TadeoRoboticsGroup/AxiomaCore-328/README.md

<div align="center">

# AxiomaCore-328

**Microcontrolador de 8 bits, libre y abierto, compatible a nivel binario con el ATmega328P.**

Diseñado íntegramente con herramientas libres y verificado contra oráculos independientes.
**Sintetiza y cierra timing en FPGA**; falta enchufar la placa. El tape-out en un PDK abierto es
la fase 6 y no ha empezado.

*Este encabezado decía «validado en FPGA y preparado para tape-out». No era cierto —el bitstream se
genera y cierra timing, pero nunca ha corrido en una placa— y contradecía la regla que este mismo
documento fija: si no hay un comando que lo demuestre, no se afirma.*








</div>

---

## Arquitectura

<picture>
  <source media="(prefers-color-scheme: dark)" srcset="images/arquitectura-dark.png">
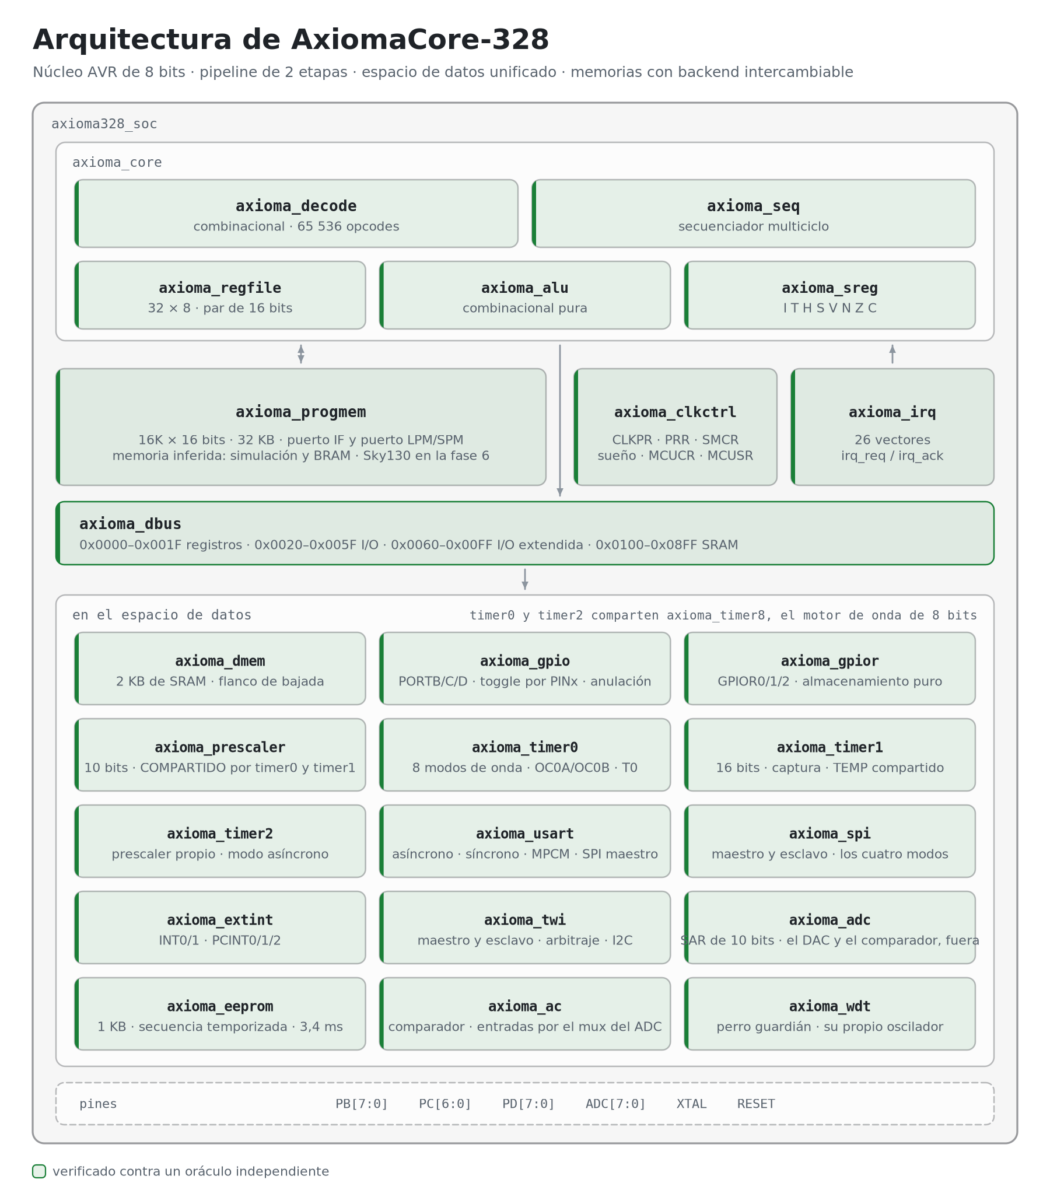
[picture p1: images/arquitectura-light.png]
Diagrama de bloques de AxiomaCore-328: núcleo, memorias, bus de datos y periféricos, con el estado de verificación de cada bloque
  
</picture>

Un núcleo AVR de 8 bits con pipeline de dos etapas, un secuenciador multiciclo que congela la
etapa de búsqueda, y memorias tras una interfaz pensada para cambiar de backend —simulación, BRAM
de FPGA o macros de SRAM en silicio— que es lo que evita que el port a ASIC sea una reescritura.
De esa interfaz hay hoy **una implementación**: memoria inferida, que vale para simulación y que la
síntesis mapea a BRAM; la de Sky130 es de la fase 6.

Los colores del diagrama no son decorativos: marcan qué está contrastado contra un oráculo
independiente y qué no. Ése es el criterio con el que se mide este proyecto — y desde que entró el
control de reloj **no queda ningún bloque pendiente en la figura**, así que la leyenda ya sólo
tiene una fila. Lo que falta del chip no es un bloque sin hacer: es el gestor de arranque de la
fase 4 y el silicio de la 6.

---

## Estado actual

Cada cifra de esta tabla sale de ejecutar `make`, no de escribirla a mano. Dos son derivadas y
conviene decirlo: las de `progmem` y `dmem` son el desglose de las 34 049 comprobaciones que
imprime `make sim-mem`, y la de la tabla de ciclos es la suma de los veintiún programas dirigidos.

| Bloque | Estado | Evidencia |
|---|---|---|
| `rtl/core/axioma_alu.v` | **Verificado** | 22 282 240 vectores sobre 24 operaciones, 0 fallos. Los mismos casos contrastados contra `simavr`: 0 discrepancias |
| `rtl/core/axioma_sreg.v` | **Verificado** | 200 029 comprobaciones contra un modelo sombra |
| `rtl/core/axioma_regfile.v` | **Verificado** | 800 064 comprobaciones en 200 000 ciclos aleatorios |
| `rtl/core/axioma_decode.v` | **Verificado** | Los 65 536 opcodes × 11 comprobaciones contra `avr-objdump`: 0 discrepancias |
| `rtl/mem/axioma_progmem.v` | **Verificado** | 12 000 comprobaciones: puerto de búsqueda, puerto de datos —`LPM` y las escrituras que le manda `axioma_spm`— y los dos a la vez |
| `rtl/mem/axioma_dmem.v` | **Verificado** | 22 049 comprobaciones, incluido el barrido completo de las 2048 direcciones y la disciplina de flanco del [ADR 0001](docs/adr/0001-memorias-en-flanco-de-bajada.md) |
| `rtl/bus/axioma_dbus.v` | **Verificado** | 790 976 comprobaciones sobre las 65 536 direcciones del espacio de datos, 0 fallos |
| `rtl/periph/axioma_gpio.v` | **Verificado** | Diferencial contra `simavr` sobre los tres puertos, más **910 200 comprobaciones** por máscara contra un modelo de la hoja de datos, incluido `PUD` |
| `rtl/periph/axioma_timer0.v` | **Verificado** | 4 480 668 comprobaciones en 224 032 ciclos contra un modelo de la hoja de datos: los ocho modos de onda, el doble búfer de `OCR0x`, las banderas y los pines de comparación |
| `rtl/periph/axioma_prescaler.v` | **Verificado** | Ídem: es el contador **compartido** con el Timer1, y la trampa nº 12 —que arrancar un temporizador no lo pone a cero— sólo se puede comprobar con los dos juntos |
| `rtl/periph/axioma_irq.v` | **Verificado** | **Exhaustivo**: las 67 108 864 combinaciones de las 26 peticiones, 201 326 592 comprobaciones de prioridad y reconocimiento |
| `rtl/periph/axioma_timer1.v` | **Verificado** | **4 475 970 comprobaciones** contra un modelo de la hoja de datos: los 16 modos de onda, la captura de entrada con su cancelador de ruido, y **el registro TEMP compartido** —la trampa nº 4—, que simavr no modela |
| `rtl/periph/axioma_usart.v` | **Verificado** | **46 650 comprobaciones** contra extremos escritos desde la hoja de datos que decodifican el pin. **Asíncrono:** las cinco longitudes de palabra, las tres paridades, uno y dos bits de parada, con y sin U2X, el periodo de bit exacto, el búfer de dos niveles y la búsqueda de errores. **Síncrono:** el periodo de `XCK` contra `f_CPU/(2·(UBRR+1))` desde `UBRR=0` —que es `f_CPU/2`—, las dos polaridades de `UCPOL` comprobadas **en el flanco** y no sólo por el dato, de maestro y de esclavo. **`MPCM`:** las tramas de datos se tiran en silencio y las de dirección entran. **SPI maestro (`MSPIM`):** los cuatro modos de `UCPOL`/`UCPHA` por los dos órdenes de bit contra un **esclavo SPI** al otro lado del cable, que una trama sean **ocho pulsos y ni uno más**, y que `XCK` esté quieto entre ellas |
| `rtl/periph/axioma_timer2.v` | **Verificado** | **4 666 627 comprobaciones** contra un modelo de la hoja de datos: las ocho tomas de su **prescaler propio** —incluidas `/32` y `/128`, que los otros dos no tienen—, que `PSRASY` lo ponga a cero y `PSRSYNC` no lo toque, y el **modo asíncrono**, que cuenta `TOSC1` y sin cristal no cuenta |
| `rtl/periph/axioma_timer8.v` | **Verificado** | La máquina de forma de onda de 8 bits, **una sola vez para el Timer0 y el Timer2**: la hoja de datos los describe con las mismas palabras. La ejercitan los dos bancos, y un mutante inyectado en ella muere en los dos |
| `rtl/periph/axioma_spi.v` | **Verificado** | **Maestro y esclavo**, contra el otro extremo del cable escrito desde la hoja de datos: los cuatro modos de `CPOL`/`CPHA` por los dos órdenes de bit, las ocho divisiones de reloj, `WCOL`, la secuencia de dos accesos que limpia `SPIF`, y que la colisión de maestros **no** salte cuando `SS` es salida —que es como selecciona a su esclavo cualquier sketch— |
| `rtl/periph/axioma_twi.v` | **Verificado** | **5 957 comprobaciones** contra un **bus de colector abierto** con un maestro y un esclavo I2C escritos desde la hoja de datos: los 26 códigos de estado de las tablas 21-2 a 21-6, las 128 direcciones de esclavo una por una, `TWAMR` contrastada contra su fórmula sobre las 128, la llamada general, el **arbitraje** —perder, no perder con los ceros propios, y perder siendo además el llamado, que da 0x68 y no 0x38—, el **estiramiento de reloj**, el error de bus y el periodo de `SCL` medido contra `f_CPU/(16+2·TWBR·4^TWPS)` en ocho combinaciones |
| `rtl/periph/axioma_adc.v` | **Verificado** | **1 606 comprobaciones** contra un **comparador escrito desde la hoja de datos**, que es lo que el [ADR 0002](docs/adr/0002-frontera-analogica-del-adc.md) compra al dejar el DAC y el comparador FUERA del RTL: se comprueba que el SAR **converge** —las diez decisiones, en orden de peso— y no sólo que el número final salga. Los **1 024 códigos** uno por uno; la duración medida **entre transiciones del DAC**, que son lo único con registro uniforme: **13 ciclos de ADC** una conversión normal y **25 la primera**; el instante del `S/H` a 1,5 y 13,5 ciclos, comprobado con la entrada moviéndose; el cerrojo de `ADCL`/`ADCH`; `ADLAR`; y el prescaler, con su `ADPS`=0 y `ADPS`=1 que dividen los dos por 2. **Y de extremo a extremo:** `hello.c` convierte el canal 3 y escribe el resultado por el puerto serie, así que el número cruza el chip entero —bus, SAR, frente analógico, registros con su cerrojo, USART y PD1— y el banco lo lee **del pin** |
| `rtl/periph/axioma_ac.v` | **Verificado** | **2 045 comprobaciones**. La comparación es analógica y llega hecha; lo que se verifica es lo que un comparador de tensión no sabe hacer solo: que `ACO` llegue **sincronizada** —«1 - 2 clock cycles», dice la hoja de datos—, los tres modos de `ACIS` con el reservado tratado como el chip lo trata, la **tabla 22-1** de la entrada negativa —el multiplexor del ADC sólo la alimenta con `ACME` puesto **y el ADC apagado**—, `DIDR1`, y que apagar el comparador **deje la interrupción de la que avisa el manual**, que es un fallo de compatibilidad que encontró la mutación |
| `rtl/periph/axioma_wdt.v` | **Verificado** | **43 comprobaciones** contra el capítulo 11 de la hoja de datos. Lo que de verdad se verifica es la **secuencia temporizada** —`WDCE` y `WDE` a uno a la vez, y el valor dentro de los cuatro ciclos siguientes—, porque un perro guardián que se pueda apagar con una escritura suelta no sirve para nada: lo que vigila es justamente un programa desbocado. Más los periodos de la tabla 11-1 —2K ciclos del oscilador por su potencia de dos—, el **orden raro de los bits** de `WDTCSR` —`WDP3` en el bit 5, con `WDCE` y `WDE` en medio—, `WDR`, y los tres modos de la tabla 11-2, incluido el que **interrumpe y después reinicia** limpiando `WDIE` para darle a la ISR un periodo entero |
| `rtl/periph/axioma_eeprom.v` | **Verificado** | **49 comprobaciones** contra el capítulo 8. Tres cosas, por orden de lo que duele si falla: la **secuencia temporizada** —`EEMPE` y, dentro de cuatro ciclos, `EEPE`—, porque una escritura perdida en la EEPROM no se nota hasta el siguiente arranque y para entonces el dato bueno ya no está; **la física de la celda**, que borra a `0xFF` y al escribir sin borrar sólo puede **apagar** unos —tratarla como RAM haría funcionar aquí código que en silicio no funciona—; y **el tiempo**, 3,4 ms borrando y escribiendo y 1,8 ms haciendo sólo una de las dos, medido en ciclos del oscilador. Más `EE_READY`, que es de **nivel** y no de bandera, y las diez líneas de dirección una por una. **1 KB en una sola BRAM** |
| `rtl/periph/axioma_extint.v` | **Verificado** | **2 501 159 comprobaciones** contra un modelo de la hoja de datos, más un programa de co-simulación contra `simavr`: los cuatro modos de `ISCn`, el de **nivel bajo** —que no deja bandera y sostiene la petición—, que la bandera se ponga con el vector deshabilitado, y que `PCMSKn` filtre la bandera mientras `PCICR` sólo filtra el salto |
| `rtl/periph/axioma_gpior.v` | **Verificado** | `GPIOR0/1/2`, tres bytes de almacenamiento del 328P. Diferencial contra `simavr` y barrido del mapa |
| `rtl/fpga/ecp5/axioma_ulx3s_top.v` | **Sintetiza y cierra timing** | Bitstream de 300 KiB para la ULX3S 25F. `nextpnr` mide **Fmax 18,25 MHz** tras el rutado, bajo restricción exigente; se corre a 12,5 MHz, con un margen de 1,46× |
| `fw/hello/hello.c` | **Verificado** | **El criterio de aceptación de la fase 2, menos el cable.** C compilado con avr-gcc y avr-libc sin modificar, corriendo sobre el SoC completo: el banco decodifica el **pin** y lee `Hola, AxiomaCore-328`, mide 19 055 baudios contra 19 200 nominales (−0,76 %), ve parpadear PB5, **decodifica del pin una transacción SPI** de tres bytes con el reloj de `SCK`, **decodifica también una transacción de la USART en modo SPI maestro** —`XCK` en PD4 con 48 flancos exactos y los bytes por PD1— y **una del TWI** —el START, la dirección `0xA0` y el STOP sobre `SDA`=PC4 y `SCL`=PC5—, y **mide el ciclo de trabajo de los SEIS canales PWM a la vez**, cada uno en su pin y con un ciclo distinto a propósito —25,39 · 78,50 · 37,49 · 74,86 · 12,49 · 62,48 %—, contra lo que da la hoja de datos. Seis cifras distintas es lo que hace visible un mapa de pines cruzado |
| `fw/blink/blink.c` | **Verificado** | C compilado con avr-gcc y avr-libc **sin modificar**: 50 000 instrucciones contra `simavr`, exactas en ciclos, con 4 entradas a ISR |
| `rtl/soc/axioma328_soc.v` | **Verificado** | **La integración es diseño, no banco de pruebas.** Las **221 direcciones** del espacio de I/O barridas por el bus real —las 224 del mapa menos las tres que el núcleo intercepta, `SPL`, `SPH` y `SREG`—: sin colisiones, el mapa coincide con la hoja de datos y los huecos se leen como `0x00` |
| `rtl/core/axioma_seq.v` | **Verificado** | 21 programas dirigidos + 10⁶ instrucciones aleatorias, 0 divergencias en estado, ciclos y espacio de datos |
| `rtl/core/axioma_core.v` | **Verificado** | Ídem. Es el módulo que une todo |
| Tabla de ciclos (nivel L3) | **Verificada** | 380 048 instrucciones con sus ciclos contrastados contra el manual, 0 desviaciones · **97 de 97 mnemónicos** |
| Regresión aleatoria | **Verde** | 10 programas × 100 000 instrucciones generadas con semilla fija, 0 divergencias |
| Entrada a interrupción | **Verificada** | 2 510 entradas a ISR contrastadas contra `simavr`, que ejecuta su propia secuencia de entrada: vector, pila, `SP` y bit `I`. Cuesta 4 ciclos, como dice el manual. Encontró dos fallos reales (ver abajo) |
| `rtl/periph/axioma_wdt.v`, `axioma_eeprom.v`, `axioma_adc.v`, `axioma_ac.v` | **Verificados** | Sus filas están arriba. Los cuatro entraron entre el 17 y el 21 de septiembre |
| `rtl/periph/axioma_clkctrl.v` | **Verificado** | `CLKPR` con su división medida en el pin, `PRR` apagando los siete periféricos uno a uno, `SMCR` con los seis modos de sueño, `MCUCR` con `PUD`, y `MCUSR`. El décimo de los diez |
| `rtl/periph/axioma_spm.v` | **Verificado** | La Flash **por páginas**: `SPMCSR`, búfer temporal de 64 palabras y las tres operaciones. 28 comprobaciones contra el capítulo 26 —el arnés diferencial no sirve aquí: un programa que se reescribe la Flash cambia el código que los dos lados ejecutan—, más la secuencia entera de un gestor de arranque en `make sim-robust`. Trajo el vector 25 |
| Síntesis FPGA, GDSII | No ejecutadas | Fases 2 y 6 |

```
regresión   48/48 objetivos en verde
mutación   329/329 fallos inyectados, 329 detectados
cobertura   99,8 % del RTL, fusionando todas las fuentes
            22 de 28 módulos al 100 %; los 14 puntos restantes, adjudicados:
            los `default` inalcanzables de la ALU y del TWI —sus casos están
            enumerados—, el `$readmemh` que sólo corre con programa precargado,
            el `next_warmup` que sólo pone el reset, y líneas de declaración cuyos
            bits van atados a constante
síntesis    sin latches · el SoC entero: 8 146 LUT4 y 1 475 FF en el ECP5
            es una MEDIDA, no un criterio: yosys aplana y comparte lógica, así
            que un cambio local mueve el total en cientos. El número atribuible
            es el de cada módulo por separado
bitstream   300 KiB · 35,4 % de las LUT y 60,7 % de la BRAM de la ULX3S 25F
            Fmax 18,25 MHz medida tras el rutado, y se corre a 12,5 MHz
            cada periférico nuevo baja un poco el Fmax; el objetivo de la fase 5
            son 32 MHz, y para eso hace falta sacar el dato de escritura de la
            SRAM del camino combinacional
```

**La fase 1 cumple su criterio de aceptación, y su única deuda está saldada.** La entrada a
interrupción, que no se podía ejercitar sin un controlador, ya se dispara desde el Timer0. Al
hacerlo aparecieron **dos fallos reales** en esa ruta: el secuenciador calculaba la dirección del
vector multiplicando por cuatro en vez de por dos, y su máquina de estados de entrada se caía al
`case` de instrucciones en los ciclos 1 a 3, porque la condición que la sostenía dejaba de
cumplirse en cuanto el primer ciclo limpiaba el bit `I`.

**Cuánto queda, y medido contra qué.** El [plan](docs/00-PLAN.md) presupuesta las fases en semanas:
1 + 4 + 2 + 5 + 3 + 2 = **17 semanas** hasta la v1.0 sobre FPGA, y de 6 a 10 más si hay silicio. La
cuenta se hace con esos pesos, no a ojo:

| Fase | Semanas | Hecho | Aporta |
|---|---:|---:|---:|
| 0 · fundación | 1 | 100 % | 1,00 |
| 1 · núcleo ISA | 4 | 100 % | 4,00 |
| 2 · SoC y FPGA | 2 | 90 % — cumplida en simulación, falta enchufar la placa | 1,80 |
| 3 · periféricos | 5 | **100 %** — las tareas y las tres cláusulas del criterio | 5,00 |
| 4 · Arduino | 3 | 80 % — `SPM`, gestor, `axioma.conf`, `boards.txt` y tres sketches cronometrados; faltan siete y publicar el paquete | 2,40 |
| 5 · endurecimiento | 2 | 0 % | 0,00 |
| | **17** | | **14,20** |

Salen **~83 % hasta la v1.0 en FPGA**. Contando el silicio —de 6 a 10 semanas más— quedaría entre
un 52 % y un 61 %, y **~56 %** tomando el punto medio. Es el presupuesto del propio plan, no una
impresión.

Los **diez periféricos de la fase 3 están dentro**, más el `SPM` por páginas que abre la fase 4, y
el mapa de registros está **barrido bit a bit**: 664 bits en 83 registros, 399 de almacenamiento,
136 con comportamiento propio y 129 reservados, **ninguno sin clasificar**. Y **los 25 vectores de
interrupción disparan desde un programa**.

El **criterio de aceptación** de la fase son tres cláusulas, y **las tres están demostradas**
desde el 24-sep:
`micros()` **no deriva** —200 y 800 periodos dan el mismo desvío de 13 ciclos, así que es latencia
acotada y no deriva— y el **scanner I2C encuentra un esclavo real y sólo a él** —127 direcciones
barridas, una contesta; con el esclavo mudo, ninguna—. Y **los 25 vectores disparan**: el que
faltaba era `SPM_READY`, y su fuente llegó con el `SPM` por páginas, que es la primera pieza de la
**fase 4**.

> Este README documenta el estado **medido**. Una versión anterior describía un diseño terminado
> y listo para producción que no existía. La regla desde entonces es simple: si no hay un comando
> que lo demuestre, no se afirma.

**➜ El plan completo está en [`docs/00-PLAN.md`](docs/00-PLAN.md).**

---

## Qué significa «compatible»

«Copia exacta» significa cosas distintas según a quién se pregunte. Aquí está fijado por escrito
en cuatro niveles, y sólo tres son alcanzables con herramientas libres.

| Nivel | Qué garantiza | ¿Objetivo? | Cómo se verifica |
|---|---|---|---|
| **L1 — Binaria** | 131 instrucciones, semántica exacta del SREG, PC de 14 bits, pila, interrupciones | Obligatorio | Diferencial contra `simavr`, instrucción a instrucción |
| **L2 — Registros** | Mismas direcciones, nombres y bits. `avr/io.h` con `-mmcu=atmega328p` funciona sin tocar nada | Obligatorio | Mapa generado desde `iom328p.h` de avr-libc, con test de CI. Y **bit a bit**: `make sim-bits` clasifica los 664 bits de los 83 registros y comprueba que **ningún reservado devuelve un uno** |
| **L3 — Ciclos** | Misma cuenta de ciclos por instrucción y misma temporización de periféricos | Sí | Tabla del manual del ISA como fichero de datos, comprobada en cada instrucción retirada |
| **L4 — Eléctrica** | 5 V, DIP-28, pinout idéntico | **No en el die.** Sí en el módulo | Sky130 no da 5 V; se resuelve con level shifters en la PCB |

De L3 dependen `_delay_ms()`, `micros()`, `SoftwareSerial`, `Servo` y cualquier protocolo
bit-bangeado como el de las tiras NeoPixel. Por eso se mide desde la fase 1 y no al final — y desde
la fase 4 se mide **con un cronómetro en el pin**: `make sim-neopixel` decodifica una trama WS2812B
de la anchura de sus pulsos y comprueba que T0H, T1H y el periodo caen dentro de la hoja de datos.

---

## Espacio de datos

<picture>
  <source media="(prefers-color-scheme: dark)" srcset="images/espacio-datos-dark.png">
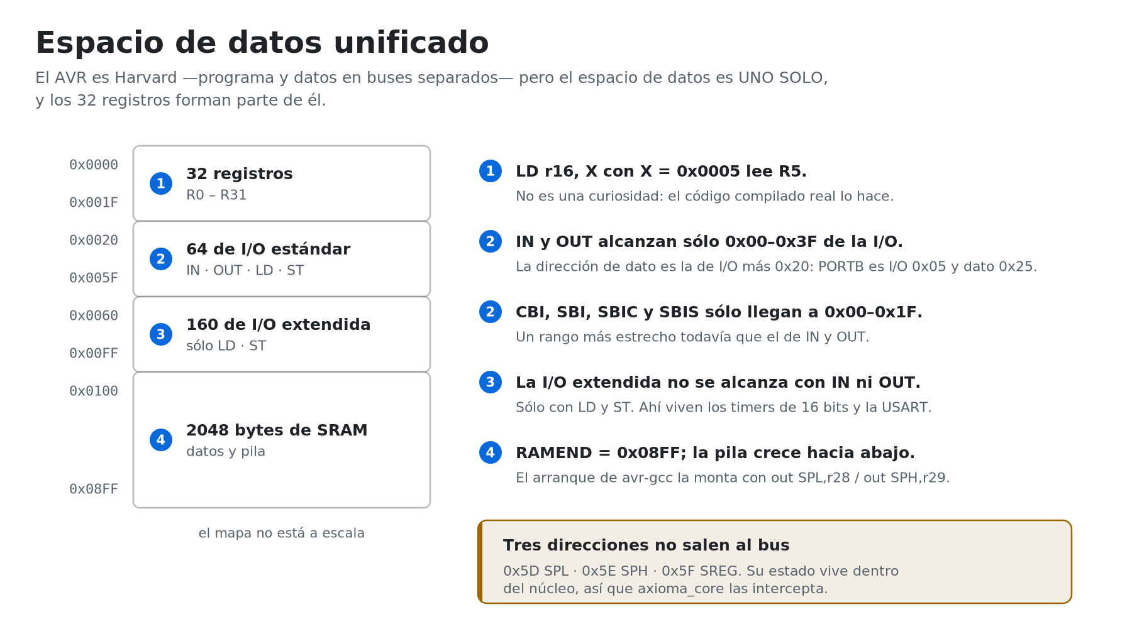
[picture p2: images/espacio-datos-light.png]
Mapa del espacio de datos unificado del AVR, de 0x0000 a 0x08FF, con las reglas de acceso de cada región
  
</picture>

El AVR es Harvard, pero su espacio de **datos** es uno solo y los registros forman parte de él.
Modelarlo de otro modo produce un núcleo que pasa los tests sintéticos y falla con código
compilado real.

---

## Verificación

<picture>
  <source media="(prefers-color-scheme: dark)" srcset="images/verificacion-dark.png">
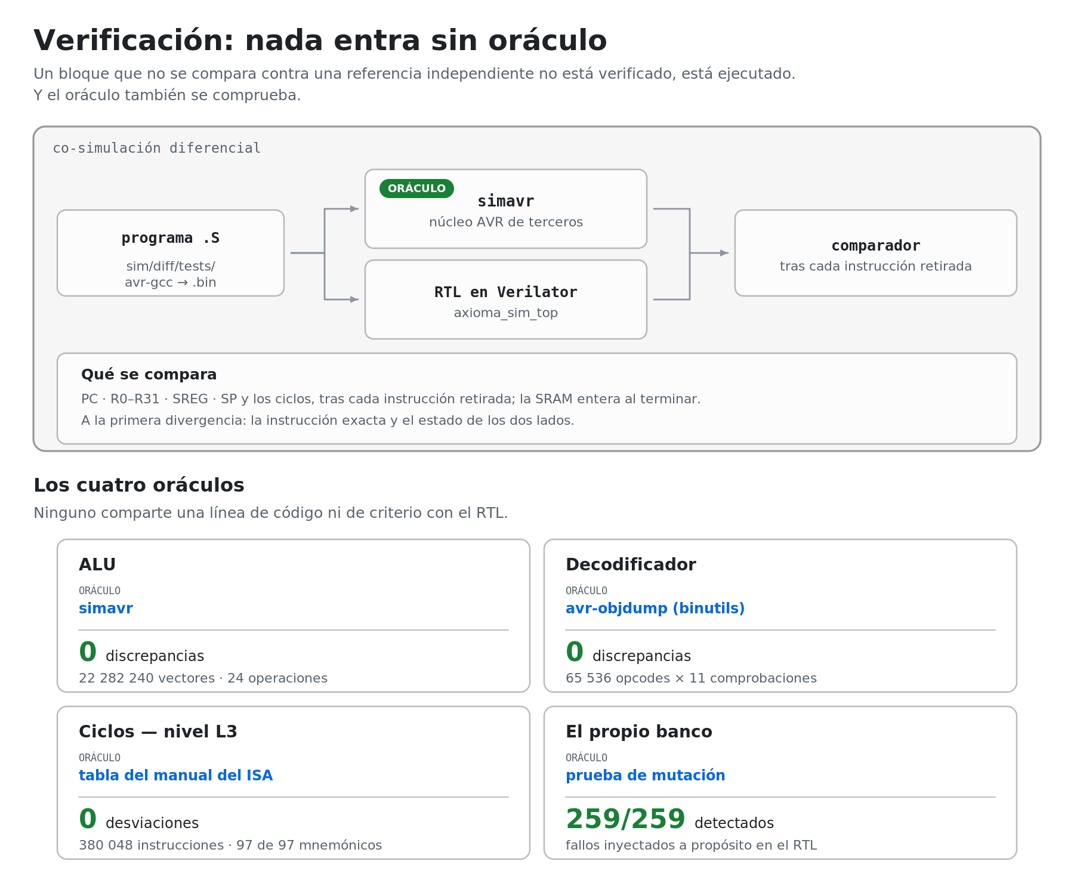
[picture p3: images/verificacion-light.png]
Esquema de la co-simulación diferencial contra simavr y resumen de los cuatro oráculos del proyecto
  
</picture>

### La regla

> **Nada entra sin oráculo. Y el oráculo también se comprueba.**

Un módulo que compila y sintetiza no cuenta como hecho. Cuenta cuando lo contrasta algo
independiente. Y como el modelo de referencia y el RTL los escribe la misma persona, hacen falta
terceros de verdad: `simavr` para la ALU y para el núcleo completo, `avr-objdump` de binutils para
el decodificador, el preprocesador de avr-gcc para el mapa de registros.

### No es teoría: fallos que sólo aparecieron así

| Fallo | Quién lo encontró | Por qué se escapaba |
|---|---|---|
| Flag `H` de `NEG` implementado como `R3 \| ¬Rd3` en vez de `R3 \| Rd3` | Contraste contra `simavr` | El mismo error estaba en el RTL **y** en el modelo de referencia, así que coincidían en los 65 536 vectores de `NEG` y ninguno podía delatar al otro. Corregir sólo uno de los dos produce **32 768 discrepancias**, medidas |
| Desfase de un ciclo en la búsqueda: cada instrucción se ejecutaba dos veces | Co-simulación diferencial | Apareció en la segunda instrucción del primer programa |
| `RET` devolvía el byte bajo duplicado | Co-simulación diferencial | Consumía la lectura de memoria del ciclo equivocado |
| `MOVW` costaba 2 ciclos donde el manual dice 1 | Comprobación de ciclos | El **estado** quedaba correcto, así que la comparación de estado lo daba por bueno |
| Cinco fallos en los propios bancos de pruebas | Prueba de mutación | El arnés de memoria no distinguía flanco de subida de bajada; el comparador del decodificador no miraba `alu_op`, con lo que confundir `ADD` con `ADC` pasaba el test |
| El arnés no comparaba la memoria | Auditoría de cobertura | `ST`, `STS`, `PUSH`, `OUT`, `SBI` y `CBI` escriben sin leer: una escritura a la dirección equivocada sólo se notaba si el programa la releía |

El caso de `MOVW` es el que mejor explica por qué hay tantas capas: la causa no estaba en el
secuenciador sino en la **interfaz** del banco de registros, que direccionaba lectura y escritura
de 16 bits con el mismo índice de par. Copiar de un par a otro exigía dos ciclos. El documento de
arquitectura ya decía que debía costar uno; el que contradecía al documento era el RTL.

### Reproducirlo

```bash
source env.sh
make check-tools
make check-all
```

**Los cuarenta y tres objetivos deben pasar**, y tardan unos veinte minutos en un portátil — la
cobertura y la co-simulación diferencial son casi todo; `synth-check` sintetiza veintitrés
módulos por separado y tarda poco. **La lista de lo que tiene que pasar vive en el `Makefile`, en
la variable `REGRESION`, y en ningún otro sitio**: estaba copiada aquí, en `INSTALL.md` y en la CI,
y tres copias de una lista son tres cifras que se desincronizan. Ya pasó con la cuenta de
objetivos, y estas dos —cuarenta y tres y veintitrés— se volvieron a medir el 24-sep.

La prueba de mutación va aparte, porque tarda y **modifica el RTL mientras corre**:

```bash
make mutation      # 329 fallos inyectados, ~25 min; MODIFICA el RTL mientras corre
```

**Los cuarenta y tres objetivos deben pasar**, y tardan unos veinte minutos en un portátil. La
prueba de mutación va aparte:

```bash
make mutation      # 329 fallos inyectados, ~25 min; MODIFICA el RTL mientras corre
```

La co-simulación diferencial recoge sola cualquier `.S` que aparezca en `sim/diff/tests/`. Hoy son
**veintiún programas**: tres de aritmética, control de flujo y memoria; cuatro dirigidos que
completan el conjunto de instrucciones —bits y espacio de I/O, las 16 ramas condicionales, `LPM` en
sus tres formas, y el control del sistema—; uno de puertos de E/S; uno que escribe por la USART sin
interrupciones; **uno que reproduce el bucle de limpieza de `.bss` que emite el enlazador**, que es
cómo el compilador compara punteros; y diez que entran en la rutina de interrupción de verdad,
desde los tres temporizadores, la USART, el SPI, el TWI, el ADC, el comparador analógico, la EEPROM,
el perro guardián y los cinco vectores externos. Entre todos ejercitan
**los 97 mnemónicos** que el ATmega328P puede ejecutar. Tras cada instrucción se comparan PC, los 32 registros, SREG, SP y los ciclos; al
terminar, la SRAM entera byte a byte.

> **97 mnemónicos y 131 instrucciones no se contradicen.** La cifra de 131 es la del manual del ISA
> y cuenta variantes que comparten codificación: `LSL` es `ADD Rd,Rd`, `CLR` es `EOR Rd,Rd`, `TST`
> es `AND Rd,Rd`, `SER` es `LDI Rd,0xFF`, y `BRBS`/`BRBC` se despliegan en dieciséis ramas con
> nombre propio. La cobertura se mide en mnemónicos porque es lo que devuelve `avr-objdump`, que es
> el oráculo: así el número sale de una herramienta y no de un recuento a mano. Los 97 son todos
> los que el 328P puede ejecutar; `SPM` es la única exclusión y es deliberada.

```bash
make mutation      # ~25 min · inyecta 329 fallos y comprueba que la regresión los caza
```

A eso se le suman **10⁶ instrucciones aleatorias** (`make sim-random`): programas válidos con
operandos aleatorios, generados con semilla fija, de modo que un fallo se reproduce exactamente con
el mismo comando. Lo difícil de un generador así no es la aleatoriedad, sino garantizar que nunca
hace algo cuyo resultado no esté definido o que los dos lados no puedan modelar igual; las
restricciones y su porqué están documentadas en la cabecera del generador.

Además, `SPM` queda fuera de la suite a propósito: el manual no le fija un número de ciclos
—dependen del backend de memoria de programa— y su emulación en simavr no es comparable.

`make mutation` **modifica el RTL en sitio** mientras corre. Tiene cerrojo y manejadores de señal,
pero no debe ejecutarse en paralelo con nada más.

Para depurar el núcleo, el arnés señala la instrucción exacta donde diverge, con el estado de los
dos lados:

```bash
./build/vdiff/diff build/diff/flow.bin
```

Estrategia completa, en seis capas: [`docs/03-verificacion.md`](docs/03-verificacion.md).

---

## Plataforma de validación

<div align="center">
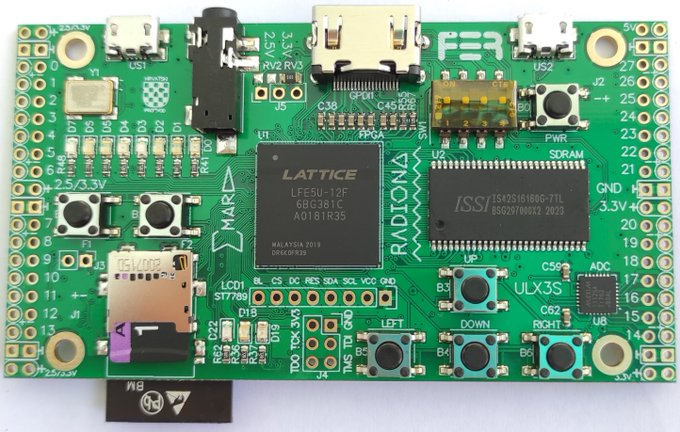
[picture p4: images/ulx3s-v316-top.jpg]
Placa ULX3S con una FPGA Lattice ECP5, memoria SDRAM, HDMI, ranura microSD y conectores de expansión
  
</div>

<div align="center">
  <sub>
    ULX3S · fotografía del repositorio <a href="https://github.com/emard/ulx3s">emard/ulx3s</a>,
    © 2016-2018 EMARD, bajo licencia tipo MIT. La unidad fotografiada monta un LFE5U-12F;
    la variante que este proyecto tiene medida es la de <strong>25F</strong>. Es la misma
    placa en las cuatro: lo único que cambia es el tamaño de la FPGA.
  </sub>
</div>

La **ULX3S** es la plataforma primaria: ECP5 con toolchain enteramente libre (yosys + nextpnr-ecp5 +
prjtrellis). El bitstream que hay medido es el de la variante **25F** —`LFE5U-25F`, 24 k LUT4— y
ocupa el **35,4 % de las LUT y el 60,7 % de la BRAM**, así que sobra sitio para el programa de
32 KB, los 2 KB de SRAM y el 1 KB de EEPROM, y sobran pines para los tres puertos.

### Dónde comprarla, con enlaces comprobados

| Placa | FPGA | Lógica | Ocupa el SoC | Dónde comprar | Precio |
|---|---|---|---|---|---|
| **ULX3S 45F** | ECP5 `LFE5U-45F` | 44 k LUT4 | ~18 % | [Mouser `CS-ULX3S-02`](https://www.mouser.com/ProductDetail/Radiona/CS-ULX3S-02) · [Electromaker](https://www.electromaker.io/shop/product/ulx3s-with-ecp5-45f) | USD, ver enlace |
| **ULX3S 85F** | ECP5 `LFE5U-85F` | 84 k LUT4 | ~10 % | [Mouser `CS-ULX3S-03`](https://www.mouser.com/en/ProductDetail/Radiona/CS-ULX3S-03) **(con existencias)** · [Crowd Supply](https://www.crowdsupply.com/radiona/ulx3s) | ~155 USD en Crowd Supply |
| ULX3S 12F | ECP5 `LFE5U-12F` | 12 k LUT4 | ~66 %, **sin medir** | [Mouser `CS-ULX3S-01`](https://www.mouser.com/ProductDetail/Radiona/CS-ULX3S-01) (bajo pedido) | USD, ver enlace |
| Colorlight 5A-75B | ECP5 `LFE5U-25F` | 24 k LUT4 | 35 % | AliExpress y eBay, varios vendedores | ~20 USD |
| Tang Nano 9K | Gowin GW1NR-9 | 8,6 k LUT4 | **no cabe** | [Sipeed en AliExpress](https://www.aliexpress.com/w/wholesale-tang-nano-9k.html) | ~18 USD |

**Tres cosas que conviene saber antes de pagar**, y que salieron de comprobar los enlaces uno a uno
el **24 de septiembre de 2026**:

1. **La variante 25F no se vende como referencia suelta.** Radiona la documenta, pero las
   referencias que los distribuidores tienen en catálogo son `CS-ULX3S-01` (12F), `-02` (45F) y
   `-03` (85F). Este proyecto está medido en la 25F porque es lo que fija el `Makefile`
   (`ECP5_DEV ?= 25k`), y en una 45F o una 85F entra con más holgura todavía: **son placas
   idénticas con la FPGA más grande**.
2. **La tienda del fabricante no envía a Colombia.** [Lectronz](https://lectronz.com/products/ulx3s-85f-v3-1-8)
   —la tienda de Intergalaktik, en Zagreb— pide **247,80 USD** por la 85F, estaba **agotada**, y su
   propia ficha dice *«This product does not ship to Colombia»*. **Mouser sí envía**, y es el camino
   sensato desde aquí.
3. **Los precios de Mouser y Crowd Supply no se pueden leer automáticamente** —las dos webs
   rechazan la lectura—, así que en la tabla van los enlaces y no una cifra inventada. El único
   precio leído directamente de su página es el de Lectronz.

**En pesos, para hacerse una idea.** La TRM del **24-sep-2026** fue de **3 264,39 COP/USD**
([Banco de la República](https://suameca.banrep.gov.co/estadisticas-economicas/informacionSerie/1/tasa_cambio_peso_colombiano_trm_dolar_usd)),
así que los **155 USD** de la 85F en Crowd Supply son unos **506 000 COP** *antes* de envío y de
aranceles de importación, que Mouser calcula en el carrito y que en Colombia no son pequeños. La
TRM cambia todos los días: el número sirve de referencia, no de presupuesto.

### Si el objetivo es un SoC con Linux, no un ATmega

Merece una aclaración, porque cambia qué placa comprar. **Una ECP5 no puede ser una Raspberry Pi 3
o 5**: ésas son SoC ARM de silicio fijo con GPU, fabricadas a 28 y 16 nm, y no existe RTL de ellas
ni cabrían. Lo que una ECP5 **sí** hace —y es justo aquello por lo que la ULX3S es conocida— es
llevar un **SoC RISC-V capaz de arrancar Linux** (LiteX, SaxonSoc), con la SDRAM, el HDMI y la
tarjeta SD de la propia placa.

Para eso, **la 85F es la compra correcta**: los 84 k LUT4 dan sitio de sobra para un núcleo RISC-V
con MMU, caches y periféricos, donde la 25F se queda corta. Está además la
[**ULX4M**](https://www.crowdsupply.com/intergalaktik/ulx4m), del mismo equipo, pensada como módulo
con hasta 1 GB de DDR3 — pero su
[repositorio](https://github.com/intergalaktik/ULX4M) la describe todavía **en desarrollo y sin
canal de venta**, así que hoy no es una opción de compra, sólo algo que vigilar.

El SoC está escrito para que cambiar de familia sea cambiar el top y las constraints bajo
`rtl/fpga/`: la memoria se infiere y no hay ni una primitiva del fabricante dentro del dispositivo.
**Pero hoy sólo existe el top del ECP5** — `rtl/fpga/gowin/` y `rtl/fpga/ice40/` son directorios
vacíos, marcadores de la fase 5, y mientras no haya un bitstream que cierre timing ahí, que el SoC
sea portable es un argumento y no una medida. Las constraints de la ULX3S **se generan** desde el
fichero oficial de la placa (`make lpf`, 36 pines), de modo que ningún pin puede quedar mal
transcrito.

**Objetivo de rendimiento:** cierre de timing a ≥ 32 MHz en ECP5, el doble de un ATmega328P real,
con F_CPU seleccionable (8/16/20/25/32 MHz) para correr binarios de Arduino sin recompilar.

---

## Cadena de herramientas

100 % libre, de la especificación al GDSII. Sin una sola herramienta propietaria.

| Etapa | Herramienta |
|---|---|
| Simulación RTL | Verilator · Icarus Verilog |
| **Oráculo del núcleo** | **simavr** |
| **Oráculo del decodificador** | **avr-objdump** (binutils) |
| Compilación de los tests | avr-gcc · avr-libc |
| Síntesis | Yosys |
| Place & route | nextpnr + prjtrellis / icestorm / apicula |
| Carga del bitstream | openFPGALoader |
| Verificación formal | SymbiYosys |
| RTL → GDSII | LibreLane 3.x + Sky130A (vía `ciel`) |
| DRC / LVS | Magic · Netgen · KLayout |

### Instalación

Casi todo llega en un único paquete:

```bash
mkdir -p ~/eda && cd ~/eda
curl -LO https://github.com/YosysHQ/oss-cad-suite-build/releases/download/2026-09-08/oss-cad-suite-linux-x64-20260908.tgz
tar xzf oss-cad-suite-linux-x64-20260908.tgz
```

El resto —toolchain AVR, `simavr` y el entorno de Python— está en
[`INSTALL.md`](INSTALL.md), incluida la vía **sin `sudo`**. Después:

```bash
source env.sh
make check-tools
```

---

## Hoja de ruta

| Fase | Contenido | Estado |
|---|---|---|
| 0 | Fundación: estructura, licencias, generador del mapa de registros, CI | **Hecha** |
| **1** | **Núcleo ISA: ALU, SREG, banco, decodificador, secuenciador, memorias, oráculos** | **Hecha** — criterio de aceptación cumplido |
| 2 | SoC mínimo: bus de datos, GPIO, Timer0, USART, IRQ. Primer bitstream | **Cumplida en simulación** — falta enchufar la placa |
| 3 | Periféricos completos: Timer1 con registro TEMP, SPI, TWI, ADC, EEPROM | **Hecha** — los diez dentro y las tres cláusulas del criterio demostradas |
| 4 | Compatibilidad Arduino: bootloader STK500v1 propio, paquete para el IDE | **En marcha** — el `SPM` por páginas y el gestor de arranque (500 B) ya están |
| 5 | Endurecimiento: cierre de timing, portes a iCE40 y Gowin, regresión nocturna | Pendiente |
| 6 | Silicio: backend Sky130, LibreLane, Tiny Tapeout y chipIgnite | Pendiente |
| 7 | Módulo DIP-28 en KiCad, compatible con el zócalo de un Arduino Uno | Pendiente |

Criterio de aceptación de la fase 1, sin ambigüedad, y su estado:

| Requisito | Estado |
|---|---|
| El conjunto de instrucciones pasa el diferencial contra simavr | 97/97 mnemónicos, en 21 programas dirigidos |
| 10⁶ instrucciones aleatorias sin divergencia | 10⁶, 0 divergencias |
| ALU 100 % exhaustiva verde | 22 282 240 vectores, 0 fallos |
| Tabla de ciclos exacta | 97/97 mnemónicos, 0 desviaciones |

La **fase 2 cumple su criterio de aceptación en simulación** desde el 11-sep: bus de datos,
puertos de E/S, Timer0 con su prescaler compartido, controlador de interrupciones, USART, top de
ECP5 y backend de BRAM. `make sim-hello` compila C con avr-gcc **sin modificar**, lo corre sobre el
SoC completo y **decodifica el pin**: el texto por el puerto serie, el LED parpadeando, una
transacción SPI y los seis canales PWM medidos a la vez. El bitstream se genera, cierra timing y
lleva el programa dentro. **Lo único que falta es enchufar la placa** (`make prog-ulx3s`).

La **fase 3 está hecha**: los diez periféricos dentro —Timer1, Timer2, las interrupciones externas,
el SPI, el TWI, el ADC, el comparador analógico, el perro guardián, la EEPROM y el control de
reloj—, las deudas D3, D12, D13 y D14 cerradas, el mapa de registros barrido bit a bit y **las tres
cláusulas de su criterio de aceptación demostradas**, cada una con un comando.

La **fase 4** tiene sus cuatro piezas de software hechas y verificadas: el **`SPM` por páginas**
(deuda D2), el **gestor de arranque STK500v1** en 500 de 512 bytes, `axioma.conf` para `avrdude` y
`boards.txt` para el IDE. El núcleo ya no escribe la Flash — pide, y quien escribe es `axioma_spm`.

De los diez sketches de la suite hay **tres**, y son los tres que **no se pueden aprobar a ojo**:
NeoPixel, `Servo` y `tone()`, los tres cronometrados en el pin. De los siete que faltan, tres
—`Blink`, `Serial` y `analogWrite`— ya los cubre `make sim-hello`. Falta además **publicar el
paquete**: el JSON del Gestor de Tarjetas lleva una URL y un SHA-256, y no se escribe antes de que
el paquete exista. Y la cláusula «que el sketch corra **en la FPGA**» necesita la placa
enchufada — es el mismo pendiente que dejó la fase 2.

El décimo periférico trajo la decisión de más alcance de la fase 3, en el
[ADR 0003](docs/adr/0003-relojes-por-habilitacion.md): **`CLKPR` y `PRR` cortan relojes de verdad**,
en forma de habilitación. El chip entero corre ahora con `clk_CPU` y `clk_I/O` separados, y con
`CLKPS`=0 quedó **bit a bit** como estaba. `SLEEP` para el núcleo de verdad: en `Idle` el Timer0
lo despierta, en `Power-down` ese mismo programa no despierta nunca y el perro guardián sí, porque
su cuenta corre con otro reloj. Y **los 25 vectores de interrupción disparan desde un programa**:
el último en tener fuente fue `SPM_READY`, que la trajo el `SPM` por páginas de la fase 4.

Los dos últimos periféricos trajeron algo que el proyecto no tenía: **lógica que no es digital de
punta a punta**. El ADC y el comparador analógico se cortan por donde lo hace la hoja de datos —el
[ADR 0002](docs/adr/0002-frontera-analogica-del-adc.md) lo razona—, de modo que lo que se sintetiza
es el registro de aproximaciones sucesivas y lo que queda fuera es el DAC y el comparador.

---

## Estructura del repositorio

```
rtl/      core · bus · mem (backends/: marcadores vacíos hasta la fase 6) · periph · soc · fpga
sim/      alu · decode · mem · diff (co-simulación) · perf (tabla de ciclos) · isa
tools/    generadores: gen_regmap.py · gen_ulx3s_lpf.py · gen_diagrams.py
docs/     plan, arquitectura, verificación, legal, ADR
fw/       bootloader · selftest · examples
sw/       arduino · platformio · avrdude
asic/     librelane · macros · reports
board/    KiCad: módulo DIP-28
legacy/   proyecto anterior, congelado como referencia
```

**Regla estructural:** cada fichero RTL existe **una sola vez**. Las herramientas reciben listas de
ficheros, nunca copias del árbol de fuentes.

### Ficheros generados, nunca escritos a mano

Una transcripción manual se desincroniza y nadie se entera hasta que algo falla.

| Generado | Desde | Garantiza |
|---|---|---|
| `rtl/soc/axioma_regmap.vh` · `docs/05-register-map.md` | `iom328p.h` de avr-libc | El nivel L2 de compatibilidad |
| `rtl/fpga/ecp5/axioma_ulx3s.lpf` | Fichero de constraints oficial de la ULX3S | Que ningún pin esté mal transcrito |
| `build/perf/cycles.bin` | La tabla del manual, vía el mnemónico de `avr-objdump` | El nivel L3 de compatibilidad |
| `images/*.png` | `tools/gen_diagrams.py` | Que las figuras no se desincronicen del diseño |

La CI falla si los dos primeros están desactualizados.

---

## Documentación

| Documento | Contenido |
|---|---|
| [`docs/00-PLAN.md`](docs/00-PLAN.md) | **Plan maestro.** Decisiones, fases, presupuesto de área, riesgos. Empieza aquí |
| [`docs/01-arquitectura.md`](docs/01-arquitectura.md) | Microarquitectura, mapa de datos, vectores, tabla de ciclos, las doce trampas |
| [`docs/03-verificacion.md`](docs/03-verificacion.md) | Estrategia de verificación en seis capas |
| [`docs/02-legal.md`](docs/02-legal.md) | Política clean-room y análisis de licencias |
| [`docs/04-herramientas.md`](docs/04-herramientas.md) | Cadena de herramientas |
| [`docs/05-register-map.md`](docs/05-register-map.md) | Mapa de registros y vectores. **Generado** |
| [`docs/06-deuda-tecnica.md`](docs/06-deuda-tecnica.md) | **Deuda técnica.** RTL que existe y no hace todo lo que su nombre promete, con qué lo desbloquea |
| [`docs/adr/`](docs/adr/) | Registros de decisiones de arquitectura: las **memorias en flanco de bajada** y la **frontera analógica del ADC** |
| [`INSTALL.md`](INSTALL.md) | Instalación desde cero, **sin `sudo`** y con las versiones fijadas |
| [`requerimiento.md`](requerimiento.md) | Requerimiento oficial del proyecto |

---

## Licencia y marco legal

**Apache-2.0** para RTL, bancos de pruebas, scripts y firmware, elegida por su concesión explícita
de patentes, que en hardware importa. El diseño físico irá bajo **CERN-OHL-P v2** y la
documentación bajo **CC-BY-4.0**. Ver [`LICENSE`](LICENSE), [`NOTICE`](NOTICE) y el inventario de
terceros en [`LICENSE-EXCEPTIONS.md`](LICENSE-EXCEPTIONS.md).

Este es un proyecto **clean-room**: se implementa desde documentación pública del conjunto de
instrucciones. No contiene RTL, layouts ni prosa de hoja de datos de terceros. Los signature bytes
son propios y no se reutilizan los del ATmega328P: hacerlo volvería el dispositivo indistinguible
de una pieza genuina, que es exactamente el escenario de falsificación. Las reglas están en
[`docs/02-legal.md`](docs/02-legal.md) y son de obligado cumplimiento para cualquier contribución.

> AVR es una marca registrada de Microchip Technology Inc. Arduino es una marca registrada de
> Arduino SA. AxiomaCore-328 es una implementación independiente, sin relación ni respaldo de
> dichas compañías.

---

## Agradecimientos

SkyWater Technology y Google por el PDK Sky130 abierto · la FOSSi Foundation por LibreLane · el
equipo de YosysHQ por Yosys, nextpnr y la OSS CAD Suite · el proyecto OpenROAD · Verilator ·
Icarus Verilog · `simavr`, sin el cual este núcleo no tendría cómo demostrar que funciona ·
EMARD y RADIONA por la ULX3S · y la comunidad de hardware abierto, que hizo posible que todo esto
se haga con un portátil y sin una sola licencia de pago.
