TadeoRoboticsGroup/AxiomaCore-328/images/arquitectura-dark.png

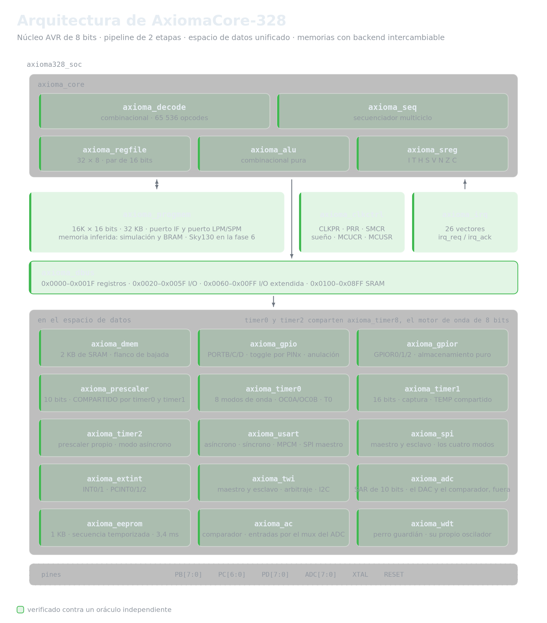
images/arquitectura-dark.png
