TadeoRoboticsGroup/AxiomaCore-328/images/AxiomaCore.jpg

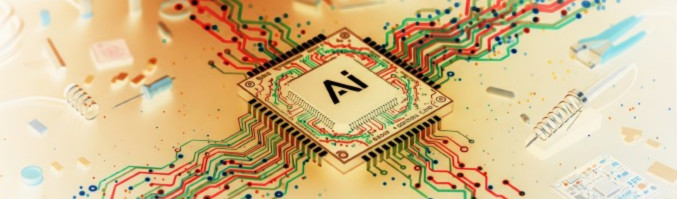
images/AxiomaCore.jpg
