TadeoRoboticsGroup/AxiomaCore-328/images/espacio-datos-dark.png

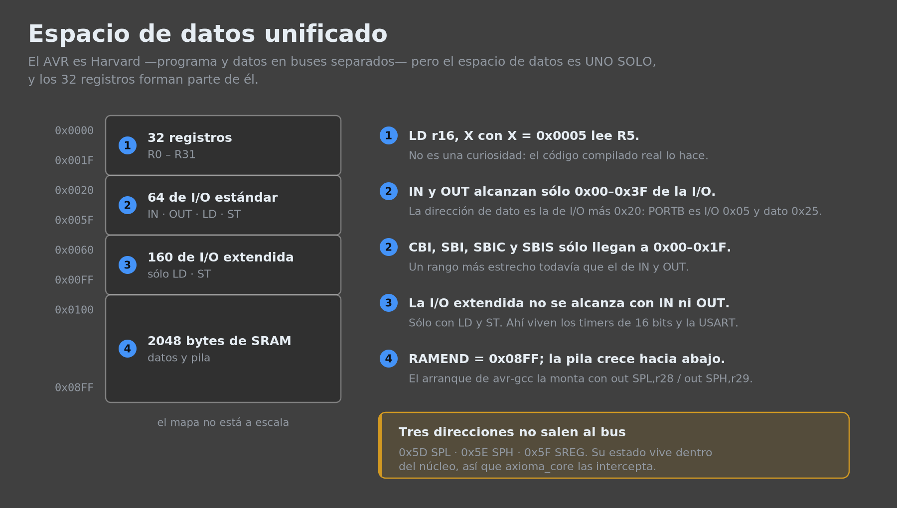
images/espacio-datos-dark.png
