TadeoRoboticsGroup/AxiomaCore-328/images/verificacion-dark.png

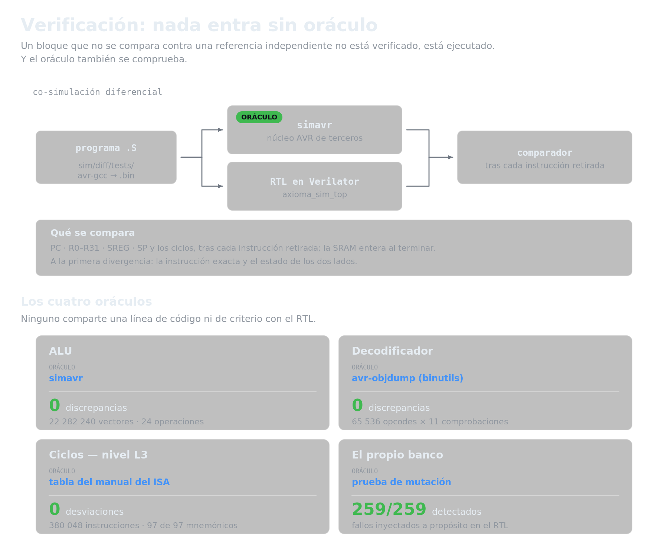
images/verificacion-dark.png
