TadeoRoboticsGroup/AxiomaCore-328/rtl/fpga/ecp5/axioma_ulx3s_top.v

// AxiomaCore-328 - top de la placa ULX3S (ECP5 25F)
// SPDX-License-Identifier: Apache-2.0
// Copyright 2026 The AxiomaCore Project
//
// Lo que rodea al chip para que funcione en una placa: reloj, reset, y celdas
// de pad de verdad. El dispositivo es `axioma328_soc`; aquí no hay lógica de
// AVR, y no debe haberla.
//
// EL RELOJ: 12,5 MHz, Y LA HISTORIA DE POR QUÉ NO SON 16.
//
// Primero: el PLL del ECP5 NO PUEDE sacar exactamente 16 MHz de los 25 de la
// placa. La salida es (25/D)·M, así que 16 exige M/D = 16/25, y como 16 y 25
// son primos entre sí, D tiene que ser múltiplo de 25 — lo que deja el
// comparador de fase en 1 MHz o menos, por debajo del mínimo del ECP5. Lo más
// cercano exacto es 15,625 MHz.
//
// Segundo: a 15,625 MHz EL DISEÑO NO CIERRA TIMING. nextpnr da 14,74 MHz, y el
// camino crítico es de flanco de subida a flanco de BAJADA: sale de la BRAM de
// la memoria de programa —5,8 ns de clk a dato—, cruza el decodificador y llega
// a la memoria de datos, que va en flanco de bajada por el ADR 0001. Todo eso
// tiene que caber en MEDIO ciclo. Es el precio de la exactitud de ciclos, y
// está medido, no estimado.
//
// Así que se corre a 12,5 MHz, la mitad justa del oscilador, con un 15 % de
// margen sobre lo que el diseño aguanta hoy. Lo que importa no es el número
// sino que sea EXACTO: con `F_CPU=12500000` la cuenta de `millis()` y los
// divisores de baudios salen sin error. Subirlo es trabajo de optimización de
// timing, con un objetivo ya escrito en el plan: 32 MHz en la fase 5.
//
// EL PULL-UP NO ES DINÁMICO EN LA FPGA, y es una diferencia conocida. El SoC
// DECLARA el pull-up por pin (`pX_pu`), como hace el 328P, pero en el ECP5 el
// modo de pull-up es un atributo ESTÁTICO del bloque de E/S: se fija en el
// `.lpf` y no se puede conmutar desde la lógica. Aquí los puertos van con
// PULLMODE=UP fijo, de modo que un pin de entrada sin nada conectado se lee 1.
// Eso coincide con el chip cuando el programa activa el pull-up y NO coincide
// cuando lo apaga —caso que la hoja de datos deja indefinido de todas formas,
// porque un pad real queda flotando—. Resolverlo de verdad pide una celda de
// E/S con pull-up conmutable, que es de la fase 5.
//
// wifi_gpio0 HAY QUE CONDUCIRLO A 1. Si se deja flotando, el ESP32 de la placa
// arranca en modo programación y reinicia la FPGA. No es opcional.

`default_nettype none

module axioma_ulx3s_top #(
    // Programa precargado en la memoria de programa del bitstream. Lo genera
    // `tools/bin2mem.py` a partir del .bin que produce avr-gcc.
    // VACÍO POR DEFECTO, y es importante: el RTL no puede depender de un
    // artefacto de compilación. Con una ruta por defecto, sintetizar en una
    // copia recién clonada fallaba con «Can not open file for $readmemh», que
    // es exactamente lo que rompió la CI. Sin programa, la memoria queda a
    // 0x0000 —NOP— y el diseño sintetiza igual.
    //
    // El programa se lo pasa quien hace el bitstream, con `chparam`.
    parameter INIT_HEX = ""
)(
    input  wire       clk_25mhz,
    input  wire       btn_reset,      // FIRE1, activo ALTO en la placa
    output wire       wifi_gpio0,

    output wire [7:0] led,

    inout  wire [7:0] portb_io,
    inout  wire [6:0] portc_io,       // PC7 no existe en el 328P
    inout  wire [7:0] portd_io,

    output wire       uart_tx,
    input  wire       uart_rx
);

    // --------------------------------------------------------------- reloj
    wire clk, pll_locked;

    axioma_pll pll (
        .clk_in(clk_25mhz),
        .clk_out(clk),
        .locked(pll_locked)
    );

    // --------------------------------------------------------------- reset
    // Se mantiene el reset hasta que el PLL engancha Y han pasado unos ciclos
    // más, porque la memoria de programa del bitstream necesita que el reloj
    // sea estable antes de la primera búsqueda. El botón lo fuerza en
    // cualquier momento; en la placa es activo ALTO.
    // EL VALOR DE ENCENDIDO ES HARDWARE DE VERDAD EN UNA FPGA: lo fija el
    // bitstream al configurar el dispositivo, y es lo único que hay antes de
    // que exista ninguna señal de reset. Verilator avisa porque en simulación
    // la inicialización en la declaración y la asignación procedural son
    // ambiguas; aquí no lo son, y por eso se silencia con el motivo al lado en
    // vez de reescribirlo peor.
    /* verilator lint_off PROCASSINIT */
    reg [7:0] rst_cnt = 8'h00;
    reg       rst_n_q = 1'b0;
    // El reinicio del perro guardian sale del SoC y lo cierra este top.
    wire      wdt_reset;
    /* verilator lint_on PROCASSINIT */

    // EL PERRO GUARDIAN ENTRA EN LA CADENA DE RESET, que es lo que hace su
    // reinicio en el chip: el SoC dice «hay que reiniciar» y el top lo cierra,
    // igual que con el boton y con el enganche del PLL. Se reinicia con la
    // misma cuenta que al arrancar, asi que el chip sale del reinicio en el
    // mismo estado en los tres casos.
    always @(posedge clk) begin
        if (!pll_locked || btn_reset || wdt_reset) begin
            rst_cnt <= 8'h00;
            rst_n_q <= 1'b0;
        end else if (!rst_cnt[7]) begin
            rst_cnt <= rst_cnt + 8'd1;
            rst_n_q <= 1'b0;
        end else begin
            rst_n_q <= 1'b1;
        end
    end

    // ------------------------------------------------------ celdas de pad
    wire [7:0] pb_out, pb_oe, pb_pu, pd_out, pd_oe, pd_pu;
    wire [7:0] pc_out, pc_oe, pc_pu;
    wire [7:0] pb_in, pd_in;
    wire [7:0] pc_in;

    // Un pin conduce cuando su DDRx lo pone a salida; si no, queda en alta
    // impedancia y se lee lo que haya fuera. Es exactamente lo que hace el
    // 328P, salvo por el pull-up estático que se explica arriba.
    genvar i;
    generate
        for (i = 0; i < 8; i = i + 1) begin : g_pb
            assign portb_io[i] = pb_oe[i] ? pb_out[i] : 1'bz;
            assign pb_in[i]    = portb_io[i];
        end
        for (i = 0; i < 7; i = i + 1) begin : g_pc
            assign portc_io[i] = pc_oe[i] ? pc_out[i] : 1'bz;
            assign pc_in[i]    = portc_io[i];
        end
        // PD0 y PD1 son el puerto serie, igual que D0 y D1 en un Uno: el pad
        // del conector y la patilla del conversor USB-serie son el mismo pin.
        // Por eso se tratan aparte, más abajo.
        for (i = 2; i < 8; i = i + 1) begin : g_pd
            assign portd_io[i] = pd_oe[i] ? pd_out[i] : 1'bz;
            assign pd_in[i]    = portd_io[i];
        end
    endgenerate

    // PC7 NO EXISTE en el ATmega328P. El SoC lo enmascara y expone los ocho
    // bits por uniformidad, así que aquí la entrada se ata a cero y la salida y
    // la dirección del bit 7 se declaran sin usar a propósito: no hay pad al
    // que llevarlas.
    assign pc_in[7] = 1'b0;
    wire unused_pc7 = &{1'b0, pc_out[7], pc_oe[7]};

    // El pull-up declarado por el SoC no se puede aplicar desde la lógica en el
    // ECP5 (ver la cabecera). Se declara sin usar a propósito, en vez de
    // borrarlo del SoC: en silicio sí se conecta a la celda del PDK.
    wire unused_pu = &{1'b0, pb_pu, pc_pu, pd_pu};

    // ------------------------------------------- el frente analogico del ADC
    // UNA FPGA NO CONVIERTE TENSIONES. El SoC saca las cinco senales del ADR
    // 0002 y aqui cuelga un modelo digital: el comparador y el S/H son los de
    // verdad —el SAR del chip aproxima igual que con silicio—, y lo sintetico
    // es de donde sale la tension. Con esto, `analogRead()` en la placa
    // devuelve un numero deterministo por canal en vez de basura.
    wire [3:0] adc_canal;
    wire [1:0] adc_ref;
    wire       adc_muestrea, adc_cmp;
    wire [9:0] adc_dac;
    wire       ac_apagado, ac_bandgap, ac_neg_mux, ac_salida;

    // ------------------------------- el oscilador del perro guardian
    // 128 kHz no son logica: en el chip es una celda RC y aqui se divide del
    // reloj de sistema. 12,5 MHz / 98 son 127,55 kHz, o sea EL VALOR DE VERDAD
    // y no uno acortado: con el, `WDP`=0 vence a los 16,1 ms y la hoja de datos
    // dice 16. Un banco que quiera ver morder al perro espera lo que se espera
    // en el chip.
    //
    // Aqui decia que el divisor «se deja corto en simulacion para no esperar un
    // siglo», y era falso en los cuatro sitios donde estaba copiado. Lo peor de
    // un comentario asi es que invita a «arreglar» lo unico que esta bien.
    reg [6:0] osc_rc_div;
    wire      osc_rc_tick = (osc_rc_div == 7'd0);
    always @(posedge clk or negedge rst_n_q)
        if (!rst_n_q) osc_rc_div <= 7'd97;
        else        osc_rc_div <= osc_rc_tick ? 7'd97 : osc_rc_div - 7'd1;


    axioma_adc_frente frente (
        .clk(clk), .rst_n(rst_n_q),
        .canal(adc_canal), .ref_sel(adc_ref), .muestrea(adc_muestrea),
        .dac(adc_dac), .cmp(adc_cmp),
        .ac_apagado(ac_apagado), .ac_bandgap(ac_bandgap),
        .ac_neg_mux(ac_neg_mux), .ac_salida(ac_salida)
    );

    // ---------------------------------------------------------- el chip
    axioma328_soc #(.INIT_HEX(INIT_HEX)) soc (
        .clk(clk), .rst_n(rst_n_q),
        .pb_in(pb_in), .pb_out(pb_out), .pb_oe(pb_oe), .pb_pu(pb_pu),
        .pc_in(pc_in), .pc_out(pc_out), .pc_oe(pc_oe), .pc_pu(pc_pu),
        .pd_in(pd_in), .pd_out(pd_out), .pd_oe(pd_oe), .pd_pu(pd_pu),
        .adc_canal(adc_canal), .adc_ref(adc_ref),
        .adc_muestrea(adc_muestrea), .adc_dac(adc_dac), .adc_cmp(adc_cmp),
        .ac_apagado(ac_apagado), .ac_bandgap(ac_bandgap),
        .ac_neg_mux(ac_neg_mux), .ac_salida(ac_salida),
        .osc_rc_tick(osc_rc_tick), .wdt_reset(wdt_reset),
        /* verilator lint_off PINCONNECTEMPTY */
        .dbg_pc(), .dbg_ir(), .dbg_retire(), .dbg_illegal(), .dbg_irq_entry(),
        .dbg_irq_vector(), .dbg_sp(), .dbg_sreg(), .dbg_reg_data(),
        /* verilator lint_on PINCONNECTEMPTY */
        .dbg_reg_addr(5'd0)
    );

    // --------------------------------------------------------- los LED
    // PORTB espejado en los ocho LED de la placa. El LED de toda la vida de
    // Arduino es el pin 13, que es PB5, así que un Blink.ino sin tocar
    // parpadea en led[5] y además se ve en el pin.
    assign led = pb_out & pb_oe;

    // ------------------------------------------------- PD0 y PD1: el serie
    // EN EL CHIP NO HAY UN "PUERTO SERIE" APARTE: hay dos pines del puerto D
    // que la USART se adueña cuando está encendida. Aquí se cablea igual que en
    // un Uno, donde D0 y D1 salen a la vez al conector y al conversor
    // USB-serie.
    //
    // PD1 conduce el conector y la línea del conversor cuando es salida —con
    // `TXEN0` puesto lo es siempre, porque el SoC anula su dirección—. Con la
    // USART apagada vuelve a ser un pin normal, y entonces lo que ve el PC es
    // el reposo del UART, que es un uno.
    assign portd_io[1] = pd_oe[1] ? pd_out[1] : 1'bz;
    assign pd_in[1]    = portd_io[1];
    assign uart_tx     = pd_oe[1] ? pd_out[1] : 1'b1;

    // PD0 lo conduce el conversor, que es quien tiene algo que decir. Si el
    // programa pone el pin como salida gana el chip, que es lo que pasa de
    // verdad en una placa: dos cosas conduciendo el mismo hilo.
    assign portd_io[0] = pd_oe[0] ? pd_out[0] : 1'bz;
    assign pd_in[0]    = pd_oe[0] ? pd_out[0] : uart_rx;

    // Sin esto el ESP32 reinicia la placa.
    assign wifi_gpio0 = 1'b1;

endmodule

`default_nettype wire
