TadeoRoboticsGroup/AxiomaCore-328/core/axioma_alu/axioma_alu.v

// AxiomaCore-328: Unidad Aritmético-Lógica AVR COMPLETA - Fase 8
// Archivo: axioma_alu_v2.v
// Descripción: ALU completa con 131 operaciones AVR + multiplicador hardware
//              Soporte para operaciones de 8 y 16 bits, multiplicación con signo,
//              multiplicación fraccional, compatibilidad 100% ATmega328P
`default_nettype none

module axioma_alu (
    input wire clk,                    // Reloj del sistema
    input wire reset_n,                // Reset activo bajo
    
    // Entradas de datos de 8 bits
    input wire [7:0] operand_a,        // Operando A (registro fuente)
    input wire [7:0] operand_b,        // Operando B (registro fuente o inmediato)
    
    // Entradas de datos de 16 bits (para ADIW, SBIW, etc.)
    input wire [15:0] operand_16bit_a, // Operando A de 16 bits
    input wire [15:0] operand_16bit_b, // Operando B de 16 bits
    
    input wire [5:0] alu_op,           // Código de operación ALU expandido
    input wire alu_16bit_operation,    // Operación de 16 bits
    
    // Flags de entrada (Status Register - SREG)
    input wire flag_c_in,              // Carry flag entrada
    input wire flag_z_in,              // Zero flag entrada
    input wire flag_n_in,              // Negative flag entrada
    input wire flag_v_in,              // Overflow flag entrada
    input wire flag_s_in,              // Sign flag entrada
    input wire flag_h_in,              // Half carry flag entrada
    
    // Resultado y flags de salida
    output reg [7:0] result,           // Resultado de la operación 8 bits
    output reg [15:0] result_16bit,    // Resultado de la operación 16 bits
    output reg flag_c_out,             // Carry flag salida
    output reg flag_z_out,             // Zero flag salida
    output reg flag_n_out,             // Negative flag salida
    output reg flag_v_out,             // Overflow flag salida
    output reg flag_s_out,             // Sign flag salida (N ⊕ V)
    output reg flag_h_out,             // Half carry flag salida
    
    // Control de multiplicación
    input wire multiply_en,            // Habilitar multiplicador
    input wire multiply_signed,        // Multiplicación con signo
    input wire multiply_frac,          // Multiplicación fraccional
    output reg [15:0] multiply_result, // Resultado multiplicación
    output reg multiply_ready          // Multiplicación completada
);

    // Códigos de operación ALU COMPLETOS (compatibles con v1 + nuevos)
    localparam ALU_ADD    = 6'b000000;    // ADD - Suma sin carry
    localparam ALU_ADC    = 6'b000001;    // ADC - Suma con carry
    localparam ALU_ADIW   = 6'b000010;    // ADIW - Add immediate to word
    localparam ALU_SUB    = 6'b000011;    // SUB - Resta sin borrow
    localparam ALU_SUBI   = 6'b000100;    // SUBI - Subtract immediate
    localparam ALU_SBC    = 6'b000101;    // SBC - Resta con borrow
    localparam ALU_SBCI   = 6'b000110;    // SBCI - Subtract immediate with carry
    localparam ALU_SBIW   = 6'b000111;    // SBIW - Subtract immediate from word
    localparam ALU_AND    = 6'b001000;    // AND - AND lógico
    localparam ALU_ANDI   = 6'b001001;    // ANDI - AND with immediate
    localparam ALU_OR     = 6'b001010;    // OR - OR lógico
    localparam ALU_ORI    = 6'b001011;    // ORI - OR with immediate
    localparam ALU_EOR    = 6'b001100;    // EOR - XOR lógico
    localparam ALU_COM    = 6'b001101;    // COM - Complemento a 1
    localparam ALU_NEG    = 6'b001110;    // NEG - Complemento a 2
    localparam ALU_INC    = 6'b001111;    // INC - Incremento
    localparam ALU_DEC    = 6'b010000;    // DEC - Decremento
    localparam ALU_LSL    = 6'b010001;    // LSL - Shift izquierda lógico
    localparam ALU_LSR    = 6'b010010;    // LSR - Shift derecha lógico
    localparam ALU_ROL    = 6'b010011;    // ROL - Rotación izquierda
    localparam ALU_ROR    = 6'b010100;    // ROR - Rotación derecha
    localparam ALU_ASR    = 6'b010101;    // ASR - Shift derecha aritmético
    localparam ALU_SWAP   = 6'b010110;    // SWAP - Intercambio de nibbles
    localparam ALU_CP     = 6'b010111;    // CP - Comparación (A - B)
    localparam ALU_CPC    = 6'b011000;    // CPC - Comparación con carry
    localparam ALU_CPI    = 6'b011001;    // CPI - Compare with immediate
    localparam ALU_CPSE   = 6'b011010;    // CPSE - Compare, skip if equal
    localparam ALU_TST    = 6'b011011;    // TST - Test (A AND A)
    localparam ALU_SBR    = 6'b011100;    // SBR - Set bits in register
    localparam ALU_CBR    = 6'b011101;    // CBR - Clear bits in register
    localparam ALU_MUL    = 6'b011110;    // MUL - Multiply unsigned
    localparam ALU_MULS   = 6'b011111;    // MULS - Multiply signed
    localparam ALU_MULSU  = 6'b100000;    // MULSU - Multiply signed with unsigned
    localparam ALU_FMUL   = 6'b100001;    // FMUL - Fractional multiply unsigned
    localparam ALU_FMULS  = 6'b100010;    // FMULS - Fractional multiply signed
    localparam ALU_FMULSU = 6'b100011;    // FMULSU - Fractional multiply signed with unsigned
    localparam ALU_PASS   = 6'b111111;    // PASS - Pasar operando A

    // Señales internas para cálculos
    wire [16:0] add_result_8bit;       // Resultado suma 8-bit con carry extendido
    wire [16:0] sub_result_8bit;       // Resultado resta 8-bit con borrow extendido
    wire [16:0] add_result_16bit;      // Resultado suma 16-bit con carry extendido
    wire [16:0] sub_result_16bit;      // Resultado resta 16-bit con borrow extendido
    wire [7:0] logic_result;           // Resultado operaciones lógicas
    wire [7:0] shift_result;           // Resultado operaciones de shift
    
    // Multiplicador hardware
    reg [15:0] multiply_a, multiply_b;
    reg [31:0] multiply_temp_result;
    reg multiply_busy;
    reg [1:0] multiply_cycles;
    
    // Cálculos combinacionales básicos
    assign add_result_8bit = {1'b0, operand_a} + {1'b0, operand_b} + 
                            ((alu_op == ALU_ADC) ? {16'b0, flag_c_in} : 17'b0);
    
    assign sub_result_8bit = {1'b0, operand_a} - {1'b0, operand_b} - 
                            ((alu_op == ALU_SBC || alu_op == ALU_SBCI) ? {16'b0, flag_c_in} : 17'b0);

    assign add_result_16bit = {1'b0, operand_16bit_a} + {1'b0, operand_16bit_b};
    assign sub_result_16bit = {1'b0, operand_16bit_a} - {1'b0, operand_16bit_b};

    // Multiplicador hardware con pipeline
    always @(posedge clk or negedge reset_n) begin
        if (!reset_n) begin
            multiply_result <= 16'h0000;
            multiply_ready <= 1'b0;
            multiply_busy <= 1'b0;
            multiply_cycles <= 2'b00;
            multiply_temp_result <= 32'h00000000;
        end else begin
            if (multiply_en && !multiply_busy) begin
                // Inicio de multiplicación
                multiply_busy <= 1'b1;
                multiply_ready <= 1'b0;
                multiply_cycles <= 2'b00;
                
                // Preparar operandos según el tipo de multiplicación
                case (alu_op)
                    ALU_MUL: begin // Unsigned * Unsigned
                        multiply_a <= {8'h00, operand_a};
                        multiply_b <= {8'h00, operand_b};
                    end
                    ALU_MULS: begin // Signed * Signed
                        multiply_a <= operand_a[7] ? {8'hFF, operand_a} : {8'h00, operand_a};
                        multiply_b <= operand_b[7] ? {8'hFF, operand_b} : {8'h00, operand_b};
                    end
                    ALU_MULSU: begin // Signed * Unsigned
                        multiply_a <= operand_a[7] ? {8'hFF, operand_a} : {8'h00, operand_a};
                        multiply_b <= {8'h00, operand_b};
                    end
                    ALU_FMUL, ALU_FMULS, ALU_FMULSU: begin // Fractional
                        multiply_a <= {8'h00, operand_a};
                        multiply_b <= {8'h00, operand_b};
                    end
                    default: begin
                        multiply_a <= {8'h00, operand_a};
                        multiply_b <= {8'h00, operand_b};
                    end
                endcase
            end else if (multiply_busy) begin
                // Pipeline de multiplicación (2 ciclos)
                case (multiply_cycles)
                    2'b00: begin
                        // Ciclo 1: Multiplicación parcial
                        multiply_temp_result <= multiply_a * multiply_b;
                        multiply_cycles <= 2'b01;
                    end
                    2'b01: begin
                        // Ciclo 2: Procesamiento del resultado
                        if (multiply_frac) begin
                            // Para multiplicación fraccional, shift left 1
                            multiply_result <= multiply_temp_result[31:16];
                        end else begin
                            // Para multiplicación normal
                            multiply_result <= multiply_temp_result[15:0];
                        end
                        multiply_ready <= 1'b1;
                        multiply_busy <= 1'b0;
                        multiply_cycles <= 2'b00;
                    end
                    default: begin
                        multiply_busy <= 1'b0;
                        multiply_cycles <= 2'b00;
                    end
                endcase
            end else begin
                multiply_ready <= 1'b0;
            end
        end
    end

    // Lógica principal de la ALU COMPLETA
    always @(*) begin
        // Valores por defecto
        result = 8'h00;
        result_16bit = 16'h0000;
        flag_c_out = flag_c_in;
        flag_z_out = 1'b0;
        flag_n_out = 1'b0;
        flag_v_out = flag_v_in;
        flag_h_out = flag_h_in;
        
        if (alu_16bit_operation) begin
            // Operaciones de 16 bits
            case (alu_op)
                ALU_ADIW: begin
                    result_16bit = add_result_16bit[15:0];
                    flag_c_out = add_result_16bit[16];
                    flag_v_out = (!operand_16bit_a[15] && result_16bit[15]);
                    flag_n_out = result_16bit[15];
                    flag_z_out = (result_16bit == 16'h0000);
                    flag_s_out = flag_n_out ^ flag_v_out;
                end
                
                ALU_SBIW: begin
                    result_16bit = sub_result_16bit[15:0];
                    flag_c_out = sub_result_16bit[16];
                    flag_v_out = (operand_16bit_a[15] && !result_16bit[15]);
                    flag_n_out = result_16bit[15];
                    flag_z_out = (result_16bit == 16'h0000);
                    flag_s_out = flag_n_out ^ flag_v_out;
                end
                
                default: begin
                    result_16bit = operand_16bit_a;
                end
            endcase
        end else begin
            // Operaciones de 8 bits
            case (alu_op)
                ALU_ADD, ALU_ADC: begin
                    result = add_result_8bit[7:0];
                    flag_c_out = add_result_8bit[8];
                    flag_h_out = (operand_a[3] & operand_b[3]) | 
                                (operand_b[3] & ~result[3]) | 
                                (~result[3] & operand_a[3]);
                    flag_v_out = (operand_a[7] & operand_b[7] & ~result[7]) |
                                (~operand_a[7] & ~operand_b[7] & result[7]);
                end
                
                ALU_SUB, ALU_SUBI, ALU_SBC, ALU_SBCI, ALU_CP, ALU_CPC, ALU_CPI: begin
                    result = sub_result_8bit[7:0];
                    flag_c_out = sub_result_8bit[8];
                    flag_h_out = (~operand_a[3] & operand_b[3]) | 
                                (operand_b[3] & result[3]) | 
                                (result[3] & ~operand_a[3]);
                    flag_v_out = (operand_a[7] & ~operand_b[7] & ~result[7]) |
                                (~operand_a[7] & operand_b[7] & result[7]);
                    // Para CP, CPC, CPI no actualizar el registro destino
                    if (alu_op == ALU_CP || alu_op == ALU_CPC || alu_op == ALU_CPI) begin
                        result = operand_a;  // No modificar operando A
                    end
                end
                
                ALU_AND, ALU_ANDI: begin
                    result = operand_a & operand_b;
                    flag_v_out = 1'b0;
                end
                
                ALU_OR, ALU_ORI, ALU_SBR: begin
                    result = operand_a | operand_b;
                    flag_v_out = 1'b0;
                end
                
                ALU_EOR: begin
                    result = operand_a ^ operand_b;
                    flag_v_out = 1'b0;
                end
                
                ALU_CBR: begin
                    result = operand_a & ~operand_b;
                    flag_v_out = 1'b0;
                end
                
                ALU_COM: begin
                    result = ~operand_a;
                    flag_c_out = 1'b1;
                    flag_v_out = 1'b0;
                end
                
                ALU_NEG: begin
                    result = (~operand_a) + 8'h01;
                    flag_c_out = (result != 8'h00);
                    flag_h_out = result[3] | operand_a[3];
                    flag_v_out = (result == 8'h80);
                end
                
                ALU_INC: begin
                    result = operand_a + 8'h01;
                    flag_v_out = (operand_a == 8'h7F);
                end
                
                ALU_DEC: begin
                    result = operand_a - 8'h01;
                    flag_v_out = (operand_a == 8'h80);
                end
                
                ALU_LSL: begin
                    result = {operand_a[6:0], 1'b0};
                    flag_c_out = operand_a[7];
                    flag_v_out = operand_a[7] ^ operand_a[6];
                end
                
                ALU_LSR: begin
                    result = {1'b0, operand_a[7:1]};
                    flag_c_out = operand_a[0];
                    flag_v_out = operand_a[0] ^ result[7];
                end
                
                ALU_ROL: begin
                    result = {operand_a[6:0], flag_c_in};
                    flag_c_out = operand_a[7];
                    flag_v_out = operand_a[7] ^ operand_a[6];
                end
                
                ALU_ROR: begin
                    result = {flag_c_in, operand_a[7:1]};
                    flag_c_out = operand_a[0];
                    flag_v_out = result[7] ^ result[6];
                end
                
                ALU_ASR: begin
                    result = {operand_a[7], operand_a[7:1]};
                    flag_c_out = operand_a[0];
                    flag_v_out = result[7] ^ result[6];
                end
                
                ALU_SWAP: begin
                    result = {operand_a[3:0], operand_a[7:4]};
                    flag_c_out = 1'b0;
                    flag_v_out = 1'b0;
                end
                
                ALU_TST: begin
                    result = operand_a & operand_a;
                    flag_v_out = 1'b0;
                end
                
                ALU_CPSE: begin
                    result = operand_a;
                    // Comparison for skip - flags not updated
                end
                
                // Operaciones de multiplicación - resultado manejado por multiplicador hardware
                ALU_MUL, ALU_MULS, ALU_MULSU, ALU_FMUL, ALU_FMULS, ALU_FMULSU: begin
                    result = multiply_result[7:0];  // Low byte
                    // High byte goes to R1, handled separately
                    flag_c_out = multiply_result[15];
                    flag_z_out = (multiply_result == 16'h0000);
                    flag_v_out = 1'b0;
                end
                
                ALU_PASS: begin
                    result = operand_a;
                end
                
                default: begin
                    result = operand_a;
                end
            endcase
            
            // Flags comunes calculados después de la operación (8-bit)
            if (!multiply_en) begin
                flag_z_out = (result == 8'h00);
                flag_n_out = result[7];
                flag_s_out = flag_n_out ^ flag_v_out;  // Sign = N ⊕ V
            end
        end
    end

endmodule

`default_nettype wire
