TadeoRoboticsGroup/AxiomaCore-328/(commit log)

2026-09-08 docs: reescritura completa de la documentación del proyecto
    Sustituye la documentación anterior, que describía un diseño terminado y
    listo para producción que no existía, por documentación verificada.
    Auditoría del estado real (medida con herramientas, no estimada):
    - axioma_cpu.v:795 fija io_data_in_cpu = 8'h00: ningún OUT/STS puede
    escribir un periférico. El SoC no está conectado.
    - axioma_sram_ctrl.v existe pero no está instanciado: no hay memoria de datos.
    - Timers 0/1/2, watchdog y comparador no están en la jerarquía.
    - yosys 0.68 confirma un latch inferido en axioma_alu.flag_s_out.
    - El script de síntesis nunca mapeó a Sky130 (sin dfflibmap ni abc -liberty).
    - layout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
2026-09-08 build: reestructuración de la fase 0
    Reorganiza el repositorio según la estructura de docs/00-PLAN.md, elimina la
    deuda legal y los artefactos falsos, y monta el sistema de construcción.
    Eliminado:
    - bootloader/optiboot/ derivado de Optiboot (GPL-2.0), incompatible con la
    licencia Apache-2.0 del proyecto. Se reescribe desde
    la especificación pública de STK500v1 en la fase 4.
    - layout/ axioma_minimal.gds eran 172 bytes con un rectángulo de
    100x100 um; axioma_cpu_layout.gds pesaba 0 bytes. Los
    scripts que los fabricaban inducían a error.
    - openlane/.../src/ copia byte a by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
    [pin_order.cfg]
2026-09-08 feat(core): ALU y SREG verificados; toolchain AVR operativo
    Primer incremento de la fase 1. La regla del proyecto es "nada entra sin
    oráculo", y aquí queda establecida con evidencia medible.
    RTL
    - rtl/core/axioma_alu.v combinacional pura, sin reloj ni estado.
    Multiplicador único de 9x9 con signo compartido
    entre MUL, MULS, MULSU y las tres fraccionales,
    en un puerto propio para que el camino crítico
    del resultado de 8 bits no lo atraviese.
    Verificado sin latches con yosys.
    - rtl/core/axioma_alu_ops.vh 24 códigos de operación y posiciones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
2026-09-08 fix(alu): corregir el flag H de NEG, detectado con simavr como tercer oráculo
    Auditoría del trabajo de la fase 1 antes de continuar con el decodificador.
    Encontró cuatro fallos reales. Este commit los corrige y añade las capas de
    verificación que faltaban.
    FALLO 1 - flag H de NEG mal implementado (funcional, en el RTL)
    El manual del ISA dice H = R3 + Rd3. Estaba implementado como R3 | ~Rd3,
    con el operando negado. Discrepaba en 512 de los 1024 casos posibles.
    El mismo error estaba en el RTL Y en el modelo de referencia de Python, así
    que se daban la razón mutuamente y el barrido exhaustivo lo daba por bueno.
    Es exactamente el fallo que un oráculo escrito por la misma pe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
    [axioma_alu.v, gen_regmap.py]
2026-09-08 test(alu): cerrar el hueco de cobertura en la preservación de flags
    Quinto fallo de la auditoría, este en el propio banco de pruebas.
    El barrido solo entraba con C y Z en el SREG; H, T e I valían siempre 0. Con
    H = 0 de entrada, una máscara que escribiera H por error produce 0 en ambos
    lados y la comparación pasa igualmente. Consecuencia: la afirmación "INC y DEC
    no tocan H" NO estaba verificada, ni contra el RTL ni contra simavr.
    No lo detectó ningún test: lo detectó auditar qué entradas recorría el barrido.
    Barrido ampliado:
    dos operandos a x b x 8 valores de SREG (con H, T e I a 1) 524 288/op
    un operando a x SREG COMPLETO (256 valores) 65 536/op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
2026-09-08 core: decodificador de instrucciones
    Decodificación combinacional del juego completo del ATmega328P. Emite una
    clase de operación con los operandos ya extraídos, en vez de un puñado de
    banderas sueltas que pueden acabar en un estado incoherente entre ellas.
    is_32bit es la salida crítica: de ella dependen la búsqueda de la segunda
    palabra en LDS/STS/JMP/CALL y el que CPSE/SBRC/SBRS/SBIC/SBIS salten una
    palabra o dos según el tamaño de la siguiente instrucción.
    Contrastado contra avr-objdump sobre los 65536 opcodes posibles: tamaño de
    instrucción, clasificación y operandos de registro coinciden, sin ninguna
    discrepancia. Las 192 codificaciones de 32 bits cuadran con la cuenta
    te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
2026-09-08 core: banco de registros
    32 registros de 8 bits: dos lecturas, una escritura, y un puerto de 16 bits
    que cubre MOVW, ADIW/SBIW y el acceso a los punteros X, Y y Z.
    El puerto de 16 bits se direcciona por índice de par, no por número de
    registro, para que la interfaz no pueda siquiera expresar una dirección
    impar. La ambigüedad desaparece por construcción en vez de por convenio.
    Las lecturas devuelven el valor anterior al flanco, que es lo que necesita
    LD Rd, X+ para leer X y escribir X+1 en el mismo ciclo. Reset a cero: el AVR
    real no lo garantiza, pero hace falta un estado inicial determinista para el
    diferencial contra simavr, que también arranca a cero.
    Probado contra un modelo so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
    [axioma_regfile.v]
2026-09-09 core: comprobar la tabla de ciclos y corregir MOVW
    Incluye el secuenciador, el nucleo, las memorias y el arnes de
    co-simulacion diferencial, que estaban sin comitear.
    La tabla de ciclos del manual pasa a ser un fichero de datos proyectado
    sobre los 65536 opcodes con el mnemonico de avr-objdump, y el arnes
    diferencial contrasta los ciclos de cada instruccion retirada.
    Encontro un fallo real: MOVW costaba 2 ciclos donde el manual dice 1. El
    estado quedaba correcto, asi que la comparacion de estado lo daba por
    bueno. La causa estaba en la interfaz del banco de registros, que
    direccionaba lectura y escritura de 16 bits con el mismo indice de par;
    ahora son independientes.
    Los ciclos de simavr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
    [axioma_core.v, axioma_dmem.v, axioma_progmem.v, axioma_regfile.v, axioma_seq.v, axioma_sim_top.v]
2026-09-09 docs: reescribir el README con el estado medido y figuras generadas
    El README describia el estado del codigo heredado, no el actual: daba por
    sin verificar bloques que ya se contrastan contra oraculos independientes.
    Ahora la tabla de estado sale de lo que imprime make.
    Tres figuras nuevas, generadas por tools/gen_diagrams.py en tema claro y
    oscuro: arquitectura del SoC con el estado de verificacion de cada bloque,
    mapa del espacio de datos unificado y esquema de la co-simulacion
    diferencial. Se generan y no se dibujan a mano por la misma razon que el
    mapa de registros: una figura hecha a mano se desincroniza y nadie se
    entera. make diagrams las regenera.
    La cabecera ya no usa el render ge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
2026-09-09 core: suite dirigida del conjunto de instrucciones y comparacion de memoria
    Cuatro programas nuevos que, con los tres anteriores, ejercitan los 97
    mnemonicos ejecutables del ATmega328P: bits y espacio de I/O, las 16 ramas
    condicionales en sus dos polaridades, LPM en sus tres formas y el control
    del sistema. La tabla de ciclos pasa de 51/97 a 97/97 mnemonicos, con
    120048 instrucciones comprobadas y 0 desviaciones.
    SPM queda fuera a proposito: el manual no le fija ciclos, dependen del
    backend de memoria de programa, y su emulacion en simavr no es comparable.
    Las direcciones de I/O que usan los tests son los tres GPIOR. Son las
    unicas que en fase 1 se comportan igual en los dos lados: el espa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
2026-09-09 core: cerrar la fase 1 con la regresion aleatoria de 10^6 instrucciones
    Ultimo requisito del criterio de aceptacion de la fase 1.
    sim/random/gen_random.py genera programas validos con operandos
    aleatorios y semilla fija; make sim-random los contrasta contra simavr.
    10 programas x 100000 instrucciones, 0 divergencias, en 2 segundos.
    Lo dificil de un generador asi no es la aleatoriedad sino garantizar que
    nunca hace algo cuyo resultado no este definido o que los dos lados no
    puedan modelar igual. Las restricciones estan documentadas una a una en la
    cabecera del generador: los punteros no son destinos aleatorios, hay
    amarre periodico de X, Y, Z y del SP, LPM solo lee dentro del programa y
    no h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
2026-09-09 docs: publicar INSTALL.md y el ADR 0001, a los que el README enlazaba
    El README enlazaba a INSTALL.md y a docs/adr/ y ninguno de los dos estaba
    en el repositorio: existian solo en el arbol de trabajo, por la regla de no
    comitear .md. Cuatro enlaces rotos para cualquiera que clonara, y el paso
    "Enlaces de la documentacion" de la CI llevaba fallando desde el dia 8.
    Son documentos nuevos que el README necesita, no actualizaciones de
    documentacion, asi que entran.
    De paso, dos cifras de INSTALL.md no cuadraban con la realidad:
    make check-tools lista 12 herramientas y no 13, y la lista de la regresion
    decia "las ocho" sobre siete comandos y se habia quedado corta. Ahora son
    los once objetivos a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
2026-09-09 bus: fabric del espacio de datos, primera pieza de la fase 2
    axioma_dbus encamina cada acceso del nucleo a la SRAM o al bus de
    perifericos, traduce las direcciones y combina las lecturas. Los registros
    y SPL/SPH/SREG no llegan hasta aqui: los intercepta axioma_core.
    El espacio de direcciones es de 16 bits, asi que es enumerable por
    completo, como la ALU y el decodificador. El banco lo barre entero en
    lectura y escritura contra un modelo de referencia transcrito del
    documento de arquitectura: 790976 comprobaciones, 0 fallos.
    La seleccion de region se registra en flanco de bajada, no de forma
    combinacional. El nucleo consume el dato en el segundo ciclo de LD, cuando
    ya no mantiene la direcci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
2026-09-10 periph: puertos de entrada/salida, y el oraculo por capas que necesitan
    Primer periferico de verdad. axioma_gpio se instancia tres veces —B, C y
    D— y el top de simulacion pasa a usar el dbus verificado en lugar de la
    decodificacion en linea. Los siete programas anteriores siguen pasando sin
    tocarlos, que era la prueba de que el refactor no rompia nada.
    LA PARTE QUE IMPORTA ES COMO SE VERIFICA. El nucleo tenia a simavr, que
    ejecuta AVR de verdad. Los perifericos no tienen un oraculo tan bueno, asi
    que se verifica por capas:
    - semantica de los registros -> diferencial contra simavr, con una tabla
    explicita de direcciones comparables que crece con cada periferico;
    - lo que simavr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
2026-09-10 docs: poner el plan y la arquitectura al dia con lo que ya esta hecho
    El repositorio publicado se contradecia: el README decia que la fase 1
    cumple su criterio de aceptacion y el plan —al que el propio README
    enlaza— seguia con las casillas sin marcar y el criterio como pendiente.
    Quien siguiera el enlace se encontraba con un documento que negaba lo que
    acababa de leer.
    Se ponen al dia las tres piezas que llevaban desfasadas desde que se
    cerraron: la suite dirigida del conjunto de instrucciones, la tabla de
    ciclos y la regresion aleatoria de 10^6. Y se marca lo hecho de la fase 2:
    el bus de datos y los puertos de E/S.
    Se documenta ademas la decision que faltaba, que era el mayor riesgo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
2026-09-11 periph: timer0, el prescaler compartido y el controlador de interrupciones
    Los tres van juntos porque estan acoplados: irq no se puede contrastar sin
    una fuente de interrupcion real, timer0 es la fuente, y entre los dos
    saldan la deuda que la fase 1 no podia saldar.
    EL PRESCALER ES UN MODULO APARTE, y no es un capricho. En el AVR no hay un
    prescaler por temporizador: hay UN contador de 10 bits libre, compartido
    por Timer0 y Timer1, del que cada uno elige una toma con sus bits CS.
    Arrancar un temporizador NO lo pone a cero; lo unico que lo resetea es
    GTCCR.PSRSYNC. Es la trampa numero 12, y en la fase 3 el Timer1 se
    engancha al mismo modulo sin tocar nada.
    DOS FALLOS REALES EN LA ENTRADA A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
    [axioma_core.v, axioma_irq.v, axioma_prescaler.v, axioma_seq.v, axioma_sim_top.v, axioma_timer0.v, diff.cpp, mutation.py]
2026-09-11 docs: el estado medido con el timer0, las interrupciones y sus oraculos
    El README publicado decia que la entrada a interrupcion estaba sin
    verificar y que timer0 e irq seguian pendientes. Ya no es cierto, y los
    tres documentos que enlaza decian lo mismo.
    README la tabla de estado con los tres modulos nuevos, la
    deuda de la fase 1 saldada y los dos fallos que
    aparecieron al saldarla. Regresion 15/15, mutacion
    92/92, tabla de ciclos sobre 160 048 instrucciones.
    00-PLAN fase 2 con timer0 e irq marcados, y la deuda de la
    fase 1 cerrada con el detalle de los dos fallos.
    01-arquitectura ax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
2026-09-11 docs: figuras con fondo transparente y con el estado que de verdad tienen
    FONDO TRANSPARENTE. La superficie de cairo ya era ARGB32, pero el lienzo se
    pintaba con el color de fondo del tema antes de dibujar, asi que el PNG
    llevaba debajo un rectangulo opaco. Ahora se deja sin pintar: la figura se
    posa sobre el color de la pagina que la muestre, sea el blanco de GitHub,
    el de una diapositiva o el de un lector con su propio tema. Antes, si ese
    color no era exactamente el que supone la paleta, se veia el borde del
    rectangulo.
    Lo que SI sigue pintado es la placa y las tarjetas de dentro: el contraste
    entre la placa gris y los bloques blancos es lo que agrupa el diagrama, y
    son elementos del dise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
2026-09-11 docs: que la transparencia de las figuras sea de toda la figura, no del margen
    El commit anterior dejo transparente el lienzo, pero la placa y todas las
    tarjetas de dentro seguian siendo rellenos OPACOS. El resultado era a
    medias: la figura no llevaba rectangulo por fuera, pero por dentro seguia
    tapando la pagina con los colores planos de GitHub, asi que sobre cualquier
    fondo que no fuera exactamente ese se veian como parches.
    Ahora TODOS los rellenos son lavados translucidos y se componen sobre lo
    que haya debajo: la placa oscurece un punto, el panel aclara, el tinte de
    estado apenas tine. La jerarquia visual se conserva —placa, panel, bloque—
    porque lo que la crea es la diferencia ent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
2026-09-11 docs: bordes con contraste en las figuras, para que se vean los recuadros
    Al convertir los rellenos en lavados translucidos, lo que dibuja cada
    tarjeta deja de ser el relleno y pasa a ser el CONTORNO. Y el contorno se
    habia quedado en un 18 % de tinta, que sobre un lavado ya de por si suave
    casi no se veia: los recuadros se deshacian.
    Ahora el borde lleva contraste de verdad y dos pesos, para que se distinga
    lo que envuelve de lo envuelto:
    line_strong la plancha exterior, ademas con el trazo a 1,6 px
    line las tarjetas y los bloques de dentro
    Siguen siendo translucidos, por el mismo motivo que los rellenos: un borde
    opaco se ve como una linea ajena en cuanto la pagina no es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
2026-09-11 ci: comprobar la sintesis y meter en la CI los bancos que faltaban
    TRES AGUJEROS DE VERIFICACION, encontrados al auditar el estado en vez de
    fiarse de la tabla del README.
    1. QUE EL RTL SIGA SINTETIZANDO NO LO COMPROBABA NADIE. El lint de
    verilator no es un sintetizador: no infiere latches, no resuelve la
    jerarquia como la herramienta que hace el bitstream, y no mide area. El
    README citaba numeros de LUT del ECP5 que ningun comando volvia a medir:
    eran una foto de un dia, no una propiedad comprobada.
    `make synth-check` pasa yosys por todo el RTL, falla si aparece UN SOLO
    latch y publica el area de cada modulo. Un latch es una rama de un
    always @(*) que no asigna una se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
2026-09-11 docs: el porcentaje de avance, medido contra el presupuesto del plan
    Decia ~40 % sobre FPGA sin decir contra que. El plan presupuesta las fases
    en semanas —1+4+2+5+3+2 = 17 hasta la v1.0 en FPGA, y de 6 a 10 mas con
    silicio—, asi que la cuenta se puede hacer y comprobar: fases 0 y 1
    cerradas y la 2 por la mitad dan ~35 % y ~24 %.
    El 40 % de ayer salio a ojo y era optimista. Con la misma cuenta, el ~35 %
    que figuraba al cerrar la fase 1 correspondia a la fase 2 al 30 %.
2026-09-11 soc: convertir la integracion en diseno, y verificarla
    EL PROBLEMA. `sim/diff/axioma_sim_top.v` empieza diciendo «NO forma parte
    del diseno», y dentro llevaba el mapa de direcciones de I/O, el cableado de
    los 26 vectores de interrupcion y un array que fingia que todo el espacio
    de I/O era RAM. Es decir: lo que nueve programas dirigidos y 10^6
    instrucciones aleatorias llevaban verificando era un banco de pruebas, no
    el dispositivo. No existia ningun modulo axioma328_soc.
    No era teorico. El bit desplazado que convertia TIMER0_COMPA en TIMER1_OVF
    —el fallo que cazo irq_timer0.S en su primera ejecucion— estaba justo en
    ese fichero. La integracion era la unica parte del chip sin banco prop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
    [axioma328_soc.v, axioma_gpior.v, axioma_sim_top.v, gen_diagrams.py, mutation.py, synth_check.py, tb_soc_map.cpp, tb_soc_top.v]
2026-09-11 fpga: el primer bitstream, y un Blink en C que pasa el diferencial
    EL HITO DE LA FASE 2 EN DOS PIEZAS. Primero: un programa en C compilado
    con avr-gcc y avr-libc SIN MODIFICAR corre identico a simavr durante 50 000
    instrucciones, exacto en ciclos, con 4 entradas a ISR. Es la primera vez
    que el proyecto ejecuta C compilado y no ensamblador escrito a mano, y
    ejercita de golpe el arranque que genera el compilador —que monta la pila
    con out SPL,r28 y copia .data—, la tabla de vectores, la entrada y salida
    de interrupcion, el prescaler compartido, el Timer0 y el puerto de E/S.
    Segundo: `make bitstream-ulx3s` produce 248 KB para la ULX3S 25F, con el
    19 % de las LUT y el 59 % de la BRAM.
    El B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
2026-09-11 docs: que placa hace falta, y por que no hace falta todavia
    El flujo entero —sintesis, emplazamiento, rutado y analisis de tiempos—
    corre en el PC. Lo unico que exige tener la placa delante es ejecutarlo de
    verdad, y la co-simulacion contra simavr es una verificacion mas fuerte que
    ver parpadear un LED.
    Queda anotado ademas el recurso que decide la compra, medido y no supuesto:
    no es la logica —4 628 LUT, el 19 % de una 25F— sino la BRAM, que va con el
    tamano de la Flash: 33 bloques con los 32 KB del 328P, 17 con 16 KB y 9 con
    8 KB. axioma_progmem ya tiene el parametro WORDS.
    De ahi que cualquier placa con un ECP5 25F valga sin tocar el flujo, solo
    las constraints.
2026-09-11 periph: la USART0, y un fallo del bus que llevaba escondido desde la fase 1
    LA USART COMPLETA en modo asincrono: 5 a 9 bits de datos, paridad par,
    impar o ninguna, uno o dos bits de parada, U2X, bufer de recepcion de DOS
    niveles, FE/DOR/UPE viajando con su trama, y los tres vectores. El modo
    sincrono y MPCM quedan declarados fuera de alcance.
    Es el primer periferico con EFECTO LATERAL DE LECTURA —leer UDR0 saca un
    byte del bufer, la trampa numero 11—. Hasta ahora ningun periferico usaba
    io_re y los dos lo declaraban sin usar a proposito.
    EL FALLO DEL BUS. Al leer de vuelta un registro de la USART aparecio que el
    RTL devolvia 0x00 donde simavr daba el valor escrito. La escritura SI
    lleg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
2026-09-11 fase2: Blink y Serial leidos del pin, que es el criterio de aceptacion
    «Un Blink.ino compilado con avr-gcc parpadea un LED, y Serial.println("Hola")
    sale por el UART y se lee en el PC.» Esto es esa frase entera menos el
    cable.
    fw/hello/hello.c se compila con avr-gcc y avr-libc SIN MODIFICAR NADA:
    <avr/io.h>, <avr/interrupt.h> y <util/setbaud.h>, que calcula el divisor a
    partir de F_CPU y BAUD y decide el solo si hace falta el modo de doble
    velocidad. Es el mecanismo del core de Arduino, y de paso comprueba que
    nuestro mapa de registros es el que avr-libc espera. Trae 30 bytes de
    .data, asi que el arranque copia desde Flash con LPM.
    El banco corre el SoC COMPLETO y DECODIFICA EL PIN, como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
2026-09-11 ci: el RTL no puede depender de un artefacto de compilacion
    La CI llevaba tres commits en rojo, desde el que trajo el bitstream, y
    siempre en el mismo paso: `make synth-check`.
    CAUSA. El top de la placa llevaba INIT_HEX = "build/fw/blink.mem" como
    valor POR DEFECTO, y axioma_progmem hace $readmemh con el. En mi arbol el
    fichero existia porque habia construido el bitstream antes; en una copia
    recien clonada —que es lo que hace la CI— no existe, y yosys aborta con
    «Can not open file for $readmemh». No era un test en rojo: era el RTL
    pidiendo un fichero que solo aparece despues de compilar otra cosa.
    ARREGLO. INIT_HEX vacio por defecto: sin programa, la memoria queda a
    0x0000 —NOP—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
    [axioma_ulx3s_top.v]
2026-09-11 ci: el banco de la USART tambien tiene que correr en el servidor
    Estaba en el Makefile y en sim-core, pero no en la CI: 44 082
    comprobaciones —la forma de onda del puerto serie contra un receptor
    escrito desde la hoja de datos— no se ejecutaban en el servidor.
    Es la segunda vez que pasa lo mismo: ya ocurrio con sim-timer0 y sim-irq.
    El Makefile y el fichero de la CI no se actualizan solos, y un banco que no
    corre alli no protege nada. Queda anotado en el contexto como regla.
    De paso, el porcentaje de avance con la fase 2 cumplida en simulacion:
    ~41 % hasta la v1.0 en FPGA y ~28 % contando el silicio, medido contra el
    presupuesto en semanas del propio plan.
2026-09-11 core: registrar la peticion a memoria, y +30 % de frecuencia sin tocar un ciclo
    EL ADR 0001 TENIA UN AGUJERO EN EL RAZONAMIENTO, no en la decision. Dice
    que la media decada de reloj que reserva para el acceso «tiene margen
    sobrado» porque «una BRAM del ECP5 accede en unos 3-5 ns». Eso contabiliza
    el tiempo de acceso de la memoria, pero NO la logica que le da de comer.
    Medido con nextpnr, el camino critico era:
    memoria de programa (5,8 ns de clk a dato, mas su arbol de multiplexores)
    -> decodificador -> banco de registros -> sumador del desplazamiento
    -> direccion de la memoria de datos, en flanco de BAJADA
    35,3 ns en media decada, 83 segmentos, 61 % de rutado. El diseño se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
2026-09-11 verif: cobertura como puerta, y los cuatro caminos que nadie ejecutaba
    AUDITORIA DE CERTIFICACION, hecha contra lo que exige una foundry y no
    contra lo que exige una FPGA. La regresion estaba en verde y la mutacion en
    108/108, asi que hizo falta la unica medida que dice lo que NO se ha
    probado: la cobertura de codigo.
    Un «0 divergencias» no dice nada sobre lo que no se ejecuto. Y la mutacion
    cubre solo parte del hueco, porque su catalogo lo escribe una persona: solo
    prueba lo que a alguien se le ocurrio romper.
    LA FUSION ES LO QUE IMPORTA. Medir solo el arnes diferencial da un 80 % y
    una conclusion falsa: el Timer0 y la USART salen bajos porque su
    funcionalidad la cubren SUS bancos. `mak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
2026-09-11 ci: la cobertura no puede depender de que alguien haya hecho source env.sh
    Primera ejecucion en el servidor y en rojo, en el paso nuevo. El script
    tomaba SIMAVR_INCLUDE del entorno y la CI no ejecuta env.sh: usa las
    variables del Makefile, que ya las tiene.
    Reproducido en local con `env -u SIMAVR_INCLUDE make coverage` antes de
    tocar nada, para no arreglar a ciegas.
    Ahora el Makefile se las pasa desde sus propias variables —una sola fuente
    de verdad— y el script ademas cae a la ruta por defecto y comprueba que el
    directorio existe, con un mensaje que apunta a INSTALL.md en vez de
    preguntar por env.sh. Funciona igual lanzado a mano que desde la CI.
    Una dependencia implicita del entorno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
    [coverage.py]
2026-09-11 docs: acotar el riesgo del doble flanco antes de abrir la fase 3
    Era el unico bloqueo de tape-out con riesgo de REDISEÑO, porque depende de
    una afirmacion que el ADR 0001 hace sin comprobar: que los macros de SRAM
    de Sky130 admiten reloj invertido. Antes de apilar cuatro perifericos mas
    encima convenia saber cuanto del diseño depende de eso.
    LO QUE SE PUEDE COMPROBAR AQUI, Y ESTA COMPROBADO. Tras registrar la
    peticion a memoria, TODO acceso a la SRAM presenta una direccion ya
    registrada. Quedan dos excepciones combinacionales y se leen en
    axioma_seq.v:
    - LDS y STS toman la direccion de la segunda palabra de la instruccion,
    que no llega hasta el primer ciclo del acceso. Van a SRAM.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
2026-09-12 periph: el Timer1 de 16 bits, con la trampa numero 4 dentro
    FASE 3 ABIERTA por donde mas valor tiene: el temporizador del que dependen
    micros(), Servo y cualquier medida de tiempo fina.
    LO QUE LO HACE DISTINTO DE «EL TIMER0 CON MAS BITS» es el REGISTRO TEMP. El
    bus del AVR es de 8 bits y estos registros son de 16, asi que el chip los
    empareja con un octavo registro invisible:
    leer TCNT1L captura el byte alto en TEMP y devuelve el bajo;
    TCNT1H devuelve TEMP. Hay que leer BAJO y luego ALTO.
    escribir va al reves: el ALTO se guarda en TEMP y el BAJO escribe los dos
    a la vez.
    Y ES UNO SOLO para TCNT1, ICR1, OCR1A y OCR1B. Eso significa que una
    interrupcion que toqu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
2026-09-12 periph: los cuatro canales de comparacion llegan al pad
    OC0A a PD6, OC0B a PD5, OC1A a PB1 y OC1B a PB2. Estaban generados y
    verificados en sus bancos desde que se escribieron los temporizadores,
    pero en el SoC salian a (). Sin ellos no hay analogWrite(), que es de lo
    primero que usa cualquiera que enchufe la placa.
    El puerto recibe dos mascaras, ovr_en y ovr_val, y el pad sale de
    pad_out = (port_q & ~ovr_en) | (ovr_val & ovr_en);
    Se anula el VALOR, nunca la direccion. La hoja de datos es explicita:
    «the Data Direction Register bit for the OC0A pin must be set as output
    before the value is visible on the pin». Un analogWrite() sin su
    pinMode() no saca nada, ni en el chip ni aqui. Mo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
2026-09-12 docs: una puerta que comprueba las rutas que cita la documentacion
    La CI validaba los [enlaces](de/markdown), que son la mitad de las
    referencias. La otra mitad son los `path/como/este` del texto corrido, y
    no los miraba nadie. Tres estaban muertas, y la peor citaba un test de
    CI que nunca se escribio:
    00-PLAN.md, 01-arquitectura.md sim/isa/regmap_check.py
    -> tools/gen_regmap.py --check
    00-PLAN.md docs/05-legal.md -> docs/02-legal.md
    02-legal.md docs/02-isa.md -> no existe
    Arreglar las tres era el trabajo de un minuto; lo que faltaba era la
    puerta. make check-docs mira solo lo que PARECE una rut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
    [check_docs.py]
2026-09-12 verif: los tres canales PWM, medidos cada uno en SU pin
    Lo destapo la cobertura, no el banco. Al cerrar D1 solo se encendia
    OC1A, asi que las tres lineas del SoC que llevan los canales del Timer0
    al puerto D no las ejercitaba nadie: salian marcadas como no cubiertas
    -que es exactamente la forma que tenia D1 antes de cerrarse-. Conectar
    un cable y que nada lo use es la misma deuda con otro nombre.
    Ahora hello.c enciende los tres canales que usa de verdad un
    analogWrite(), y CON CICLOS DE TRABAJO DISTINTOS A PROPOSITO:
    OC1A PB1 25,39 % medido 25,39 %
    OC0A PD6 75,00 % medido 74,86 %
    OC0B PD5 12,50 % medido 12,49 %
    Los tres numeros distintos son la prueba. Con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
2026-09-12 ci: la mutacion tambien corre en el servidor
    La prueba de mutacion es la verificacion de la verificacion, y hasta hoy
    solo corria en el portatil de quien se acordaba. La regla del proyecto
    dice que es obligatoria; una regla que el servidor no comprueba no es
    una regla.
    No es teorico: el catalogo se ha quedado obsoleto cuatro veces al tocar
    el RTL -tras registrar el camino de memoria, tras arreglar el bus, y al
    anadir la USART y el Timer1-, y cada vez fue un mutante que dejo de
    aplicarse en silencio. Peor: un mutante SOBREVIVIO, el que intercambia
    dos vectores de interrupcion, y eso destapo que el arnes le estaba
    diciendo a simavr que vector habia tomado el RTL.
    Va en un job aparte y no com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
2026-09-12 periph: INT0, INT1 y los tres PCINT, que son cinco vectores
    Primera pieza de la fase 3, y la que usa attachInterrupt(). Van en un
    solo modulo aunque sean DOS MECANISMOS distintos:
    INT0/INT1 detectan lo que diga ISCn -nivel bajo, cualquier flanco,
    bajada o subida-, son por PIN y distinguen la direccion.
    PCINTx detectan CUALQUIER CAMBIO en los pines de su mascara, un
    vector por puerto, y ni distinguen flanco ni dicen que pin
    cambio: eso lo averigua la ISR leyendo PINx.
    Comparten el sincronizador y la disciplina de banderas, que es lo unico
    delicado que hay aqui; separarlos duplicaria justo eso.
    TRES COSAS QUE NO SON OBVIAS, y que estan en el b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
2026-09-12 periph: el Timer2, y con el los seis canales PWM del 328P
    No es el Timer0 con otro nombre, y confundirlos es el fallo que habria
    cometido cualquiera. Lo que tiene distinto:
    PRESCALER PROPIO, no el contador compartido de los otros dos, y con
    dos tomas que ellos no tienen: /32 y /128. Existen para dividir
    32 768 Hz y dar un segundo exacto -32768/128 = 256, que es justo un
    desbordamiento de 8 bits-.
    LOS BITS CS ESTAN CORRIDOS: aqui CS=4 es clk/64 y no clk/256. Un
    Timer2 copiado del Timer0 cuenta cuatro veces mas lento y ninguna otra
    cosa falla. Hay un mutante que inyecta justo esa tabla.
    NO TIENE ENTRADA DE RELOJ EXTERNO. Donde el Timer0 pone T0, este pone
    el oscilador de T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
2026-09-12 periph: el SPI, maestro y esclavo, con el otro extremo del cable como oraculo
    simavr no sirve aqui: su modelo transporta el byte entero por una IRQ
    interna y programa un temporizador: no hay bits, ni SCK, ni pines, y
    leer SPDR devuelve lo que se escribio porque no hay nadie al otro lado.
    Y la forma de onda ES el periferico: un SPI con los cuatro modos mal
    tiene los registros perfectos y los datos desplazados un bit, que es un
    fallo que no da ningun error -la pantalla pinta basura y el programa
    cree que va bien-.
    Asi que el banco implementa un maestro y un esclavo desde la hoja de
    datos y los enchufa al DUT. Si los dos extremos no coinciden bit a bit,
    uno de los dos esta mal, y el de aqui no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
    [axioma328_soc.v, axioma_gpio.v, axioma_sim_top.v, axioma_spi.v, coverage.py, diff.cpp, gen_diagrams.py, hello.c]
2026-09-12 docs: publicar el registro de deuda tecnica, al que ya apunta el RTL
    Se quedaba fuera del repositorio por la convencion de los .md, pero dos
    modulos publicados lo citan por su ruta -axioma_extint.v y
    axioma_timer2.v- y la arquitectura habla de «la deuda D10» sin que haya
    donde leerla. Una referencia rota en lo publicado es justo el caso en el
    que un .md entra.
    Es el documento que separa dos cosas que no son lo mismo: lo que esta EN
    EL PLAN y lo que esta A MEDIAS. Diez entradas, cuatro cerradas con su
    evidencia -los canales de comparacion al pad, la anulacion de direccion
    que trajo el SPI, el objetivo sim-isa que salia con error y las rutas
    muertas de la documentacion-, tres esperando su f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
2026-09-12 docs: quitar una frase que el comprobador de enlaces lee como enlace
    El documento de deuda explicaba que la CI ya validaba «los [enlaces](de/markdown)», y
    eso ES un enlace de Markdown a una ruta que no existe. El paso de enlaces de la CI
    habria fallado en el commit anterior; se dice con palabras y se acabo.
2026-09-14 regmap: los bits se asocian por proximidad, no por prefijo del nombre
    avr-libc no nombra los bits con el prefijo de su registro. TWINT es de TWCR,
    ADEN de ADCSRA, DDB0 de DDRB, OCR2BUB de ASSR. La regla de prefijo dejaba sin
    un solo bit a SPCR, ADCSRA, ADMUX, UCSR0A, TIMSK0, WDTCSR, SPMCSR, EECR, MCUCR,
    PRR, TWCR, TWSR y los tres DDRx: casi todos los registros de control del chip.
    Y no avisaba. En la tabla salia un guion, que se lee igual que "este registro no
    tiene bits con nombre". El nivel L2 promete las direcciones Y LOS BITS; los
    bits solo estaban verificados donde el nombre coincidia por casualidad.
    Lo autoritativo es el orden de la cabecera: un registro y pegado detras su
    bloque de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
2026-09-14 regmap: una constante por nombre de bit, y una guarda por si dejan de serlo
    avr-libc repite algunos nombres de bit en dos registros: OCR2_0..OCR2_7 van
    detras de OCR2A Y detras de OCR2B. La regla de proximidad los asociaba a los
    dos, el generador los emitia dos veces y el resultado era una declaracion
    duplicada de `localparam`.
    No lo cazaba nadie porque HOY NINGUN MODULO DEL RTL INCLUYE ESTA CABECERA: cada
    periferico fija sus direcciones como literales y quien las verifica es la tabla
    MAPA[] de sim/soc/tb_soc_map.cpp, escrita desde la hoja de datos, que es una
    fuente independiente. La cabecera se comprueba que este al dia, pero no se
    elabora, asi que el error habria aparecido el dia que alg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
    [gen_regmap.py]
2026-09-14 docs: una puerta para la cuenta de vectores, que estaba mal en tres sitios
    Habia TRES cifras distintas para la misma cosa -cuantos de los 25 vectores no
    tienen todavia un periferico que los dispare-: docs/00-PLAN.md decia 10 y
    listaba el Timer2 y el SPI, que llevaban dos dias dentro; docs/06-deuda-tecnica
    decia 7. La verdad, leida del RTL, eran 6.
    Ninguna de las dos estaba mal cuando se escribio: se quedaron atras, que es
    peor, porque una cifra obsoleta se lee igual que una cierta. Es el mismo fallo
    que las rutas muertas que cerro `make check-docs` y que las figuras del README
    que se quedaban atras sin avisar, y la respuesta es la misma: una puerta, no un
    repaso.
    El oraculo es la concatena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
2026-09-14 periph: el TWI, con arbitraje y estiramiento sobre un bus de colector abierto
    El que usa `Wire`, y el primero que no es un cable sino un BUS. Nadie conduce
    nunca una linea hacia arriba: se tira hacia abajo o se suelta, y el pull-up es
    el que sube el nivel. De ahi salen tres propiedades que ningun periferico
    anterior tenia, y las tres se verifican:
    - ARBITRAJE. Dos maestros a la vez, y quien suelta la linea y la lee baja se
    calla en ese mismo bit, sin STOP y sin perder el dato.
    - SINCRONIZACION DE RELOJ. El semiperiodo alto no empieza cuando soltamos
    SCL, sino cuando el pin sube de verdad.
    - ESTIRAMIENTO. Mientras TWINT este puesto se tira de SCL, que es lo que hace
    que una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
2026-09-14 periph: la USART cierra su deuda D3 con el modo sincrono y MPCM
    EL MOTOR DE TRAMA ES EL MISMO, y de ahi que saliera barato: arranque, datos,
    paridad y parada se cuentan igual en asincrono y en sincrono, y lo unico que
    cambia es QUIEN dice "avanza un bit". En asincrono lo dice el generador de
    baudios con su sobremuestreo por dieciseis; en sincrono, los flancos de XCK, uno
    por bit. Con el sobremuestreo puesto a uno el contador se agota en el mismo
    pulso y LA MAQUINA DE ESTADOS NO SE TOCO.
    El orden fue el que ya salvo el refactor del Timer0: meter la indireccion
    dejando el camino asincrono identico, correr sus 44 082 comprobaciones como red
    -la misma cifra exacta, 0 fallos- y solo despues anad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
2026-09-15 periph: el puerto serie vive en PD1 y PD0, y cierra la deuda D13
    TXD y RXD salian del SoC por dos puertos propios, asi que el pinout del
    encapsulado no era el del 328P en esos dos pines: un programa no podia usarlos
    como E/S general con la USART apagada, y la USART no se adueniaba de ellos
    cuando estaba encendida.
    NO HIZO FALTA NADA NUEVO. axioma_gpio ya tenia las dos anulaciones -la de VALOR,
    del cierre de D1, y la de DIRECCION, que llego con el SPI-, de modo que el
    trabajo era cablear, y la tabla 14-9 dice exactamente como:
    PD1, con TXEN0 puesto, es SALIDA pase lo que pase en DDRD1, y la conduce el
    transmisor. Anulacion de direccion Y de valor.
    PD0, con RXEN0 puesto, es ENTRAD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
2026-09-15 docs: nueve cifras del README que ya no eran las que imprime make
    Ninguna cifra de este repositorio se inventa: todas las imprime un comando. Pero
    copiarlas es un acto manual, y nueve se habian quedado atras a la vez. Se
    encontraron comparando el README contra la salida de make, una por una:
    GPIO 909 881 -> 909 708 comprobaciones por mascara
    TWI 4 716 -> 5 957
    diferencial 9 -> 16 programas dirigidos (en dos sitios)
    ciclos L3 160 048 -> 300 048 instrucciones contra el manual
    entradas a ISR 294 -> 1 172 contrastadas contra simavr
    sintesis 7 602 -> 8 259 LUT4 y 1 209 -> 1 211 FF
    cobertura 17 de 23 -> 17 de 22 modulos al 100 %
    program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
2026-09-17 periph: la USART como maestro SPI, y cierra la deuda D12
    Es el mismo motor de trama por tercera vez -asincrono, sincrono y ahora MSPIM-,
    con la trama mas corta que se puede escribir: ocho bits de datos y nada mas. Lo
    que NO se pudo reutilizar son tres cosas, y las tres son de fondo.
    SIN BIT DE ARRANQUE, LA TRAMA LA DELIMITA EL RELOJ. De ahi sale todo lo demas:
    el receptor no puede buscar un flanco de bajada, asi que arranca con el
    transmisor; y la trama no puede terminar "cuando toque el bit de parada", asi
    que termina en el OCTAVO FLANCO DE SALIDA DEL PULSO. Ese es el unico instante
    que existe con las dos fases de UCPHA y el unico que deja el pin en su nivel de
    reposo: parar en la ultima m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
2026-09-17 verif: que XCK sale por PD4 lo dice el pin, no el banco del periferico
    EL BANCO DE UN PERIFERICO NO VE EL SOC. tb_usart.cpp verifica el modo SPI
    maestro contra un esclavo escrito desde la hoja de datos, pero no puede decir
    POR QUE PIN sale XCK: si el SoC lo encaminara a otro bit del puerto D, sus 46 650
    comprobaciones seguirian pasando enteras. Es la misma leccion que dejo el SPI —si
    nadie mira el pin, el mapa de pines no esta verificado— y estaba sin aplicar al
    reloj de MSPIM.
    Ahora hello.c hace una TRANSACCION MSPIM de tres bytes, en modo 3 y con el bit
    mas significativo primero, y tb_soc_uart.cpp la decodifica DEL PIN: XCK en PD4,
    MOSI en PD1. Comprueba tres cosas que solo se ven ahi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
2026-09-17 verif: SDA y SCL tambien se comprueban en el pin, y no lo hacia nadie
    SE INYECTARON LOS DOS FALLOS Y SOBREVIVIAN A LA REGRESION ENTERA: SDA y SCL
    intercambiados en el SoC, y el TWI aduenandose de dos pines del puerto C que no
    son suyos. Ni un banco fallaba.
    No era un fallo del RTL: era que NADIE MIRABA ESOS PINES. El banco del TWI
    cuelga de su propio bus de colector abierto y no ve el SoC, asi que no puede
    decir por donde sale una linea. Y `twi.S` en el diferencial tampoco, por una
    razon mas fina: ALLI EL PAD SE REALIMENTA SOBRE SI MISMO, y un lazo cerrado se
    cree cualquier cosa — intercambiar SDA y SCL es simetrico y pasa sin enterarse.
    Ahora hello.c hace un START, una direccion y un ST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
2026-09-17 docs: el porcentaje de avance se quedo dos perifericos atras
    El README decia "~49 % hasta la v1.0 en FPGA" y a la vez "cinco de sus diez
    perifericos". Las dos cifras no pueden ser ciertas: el 49 % sale de la cuenta
    con TRES perifericos dentro, que es como estaba el 12-sep. La frase se actualizo
    y el numero no.
    Recalculado con los pesos del propio plan, y ahora la cuenta va a la vista en una
    tabla para que se pueda comprobar sin creerse nada:
    fase 0 1 sem x 100 % = 1,00
    fase 1 4 sem x 100 % = 4,00
    fase 2 2 sem x 90 % = 1,80 cumplida en simulacion, falta la placa
    fase 3 5 sem x 55 % = 2,75 cinco de diez, mas las tres deudas de USART
    fase 4 3 sem x 0 % =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
2026-09-17 docs: ADR 0002, donde termina el RTL del ADC y empieza lo analogico
    Antes de escribir una linea del ADC hay que decidir una cosa, y es la unica del
    proyecto que no se puede arreglar despues: DONDE SE CORTA.
    El ADC es un convertidor de aproximaciones sucesivas. Tres piezas: multiplexor,
    comparador con su DAC, y el registro que va probando bits. Las dos primeras son
    analogicas; la tercera es logica y se sintetiza como cualquier otra.
    LA OPCION FACIL ES LA TRAMPA. Un modulo que reciba el valor ya convertido y lo
    publique tras N ciclos hace que analogRead() devuelva el numero correcto, pasa
    cualquier banco que mire el resultado, y NO ES UN ADC: no hay SAR, no hay DAC y
    no hay nada que llevar a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
2026-09-17 periph: el ADC, el registro de aproximaciones sucesivas
    Es el primer modulo del proyecto que NO ES DIGITAL DE PUNTA A PUNTA, y por eso
    lo primero fue decidir donde se corta: el ADR 0002, comiteado antes que una sola
    linea de RTL. Aqui dentro viven el SAR y su secuenciador; el DAC y el comparador
    se quedan FUERA, detras de cinco senales. Es el corte que dibuja la figura 23-1
    de la hoja de datos.
    LO QUE ESO COMPRA, Y ES TODO EL PUNTO: el banco escribe el frente analogico
    -un S/H que retiene en su pulso y un comparador que responde v>=dac- y comprueba
    que el SAR CONVERGE. Las diez decisiones, en orden de peso, cada una anadiendo su
    bit y conservando los anteriores. Un ADC que acierta por casua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
2026-09-17 soc: el ADC dentro del chip, con su vector y su DIDR0
    El modulo estaba verificado y el dispositivo no lo llevaba. Ahora si: seis
    registros en la I/O extendida, el vector 21 disparando -21 de los 25 ya tienen
    fuente-, DIDR0 llegando al puerto C y las cinco senales del ADR 0002 saliendo
    del SoC hacia quien lo instancie.
    EL MODELO DEL FRENTE ANALOGICO VIVE EN rtl/fpga/, NO EN EL SOC, y eso es el ADR
    entero: una FPGA no convierte tensiones y los bancos tampoco, asi que hace falta
    algo al otro lado del cable — pero ese algo no es el chip. El comparador y el
    S/H que lleva son los de verdad -el SAR aproxima igual que con silicio-; lo
    sintetico es de donde sale la tension.
    TRES COSAS QUE NINGUN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
2026-09-18 periph: el comparador analogico, y la fase 3 con siete de sus diez
    Se corta por el mismo sitio que el ADC -la comparacion es analogica y llega
    hecha, ADR 0002-, y lo que queda dentro es lo que un comparador de tension no
    sabe hacer solo.
    LAS DOS ENTRADAS NO SON DOS PINES FIJOS, y ahi esta toda la logica: la positiva
    es AIN0 o la referencia interna de 1,1 V segun ACBG; la negativa es AIN1 o EL
    CANAL QUE ELIJA ADMUX si ACME esta puesto Y EL ADC APAGADO. Es la tabla 22-1
    literal, y ese ACME vive en un registro del ADC, asi que el SoC cablea los dos
    periferricos entre si. Tambien cablea ACIC, que lleva la salida del comparador a
    la captura del Timer1 en lugar del pin ICP1.
    2 045 comprobaciones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
2026-09-18 periph: el perro guardian, con su secuencia temporizada
    LO QUE DE VERDAD HAY QUE IMPLEMENTAR BIEN NO ES LA CUENTA, ES LA SECUENCIA: un
    perro guardian que se pueda apagar con una escritura suelta no sirve para nada,
    porque lo que vigila es justamente un programa desbocado, y un programa
    desbocado escribe en cualquier registro. WDCE y WDE a uno A LA VEZ, y el valor
    dentro de los CUATRO ciclos siguientes; fuera de esa ventana, las escrituras a
    WDE y al prescaler se ignoran. WDIE no esta protegido: lo protegido es lo que
    puede DESACTIVAR la vigilancia.
    SU RELOJ NO ES EL DEL SISTEMA, y esa es su razon de ser: si dependiera del
    principal, un fallo que parase ese reloj pararia tambien al vigilante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
2026-09-18 soc: el perro guardian dentro del chip, con WDR llegando de verdad
    El modulo estaba verificado y el dispositivo no lo llevaba. Ahora si: WDTCSR en
    el mapa, el vector 6 disparando -23 de los 25 ya tienen fuente- y las dos cosas
    que solo existen a nivel de SoC.
    WDR ERA LA INTERESANTE. La instruccion ya se decodificaba y el secuenciador la
    ejecutaba como un NOP de un ciclo, asi que el nucleo la daba por buena SIN QUE
    NADIE NOTARA si el pulso salia o no: para el nucleo, WDR y NOP son la misma
    cosa. Ahora `axioma_seq` exporta el pulso y el SoC lo lleva al vigilante, y
    wdt_irq.S lo usa de las dos maneras -rearmando a tiempo, y dejando de hacerlo-.
    El mutante que corta ese cable muere ahi.
    EL REI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
2026-09-21 periph: la EEPROM, con su secuencia temporizada y la fisica de la celda
    Tres cosas, por orden de lo que duele si falla.
    LA SECUENCIA TEMPORIZADA -EEMPE y, dentro de cuatro ciclos, EEPE-. Es la
    tercera vez que aparece este patron en el chip, despues del perro guardian y de
    CLKPR, y aqui el motivo es el mas claro de los tres: una escritura perdida en la
    EEPROM NO SE NOTA HASTA EL SIGUIENTE ARRANQUE, y para entonces la calibracion de
    la maquina ya no esta.
    LA FISICA DE LA CELDA, que es lo que no es RAM. Borrar la pone a 0xFF; escribir
    sin borrar solo puede APAGAR unos, nunca subirlos. Por eso hay tres modos y no
    uno: separar el borrado del escrito sirve para ir mas rapido cuando se sabe que
    l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
2026-09-22 soc: la EEPROM dentro del chip, y solo SPM_READY se queda sin vector
    Cuatro registros en el mapa, el vector 22 disparando y el oscilador RC
    compartido con el perro guardian — que es lo que hace el chip: los 3,4 ms de una
    grabacion y los milisegundos del perro salen de la MISMA fuente, y si esa fuente
    deriva, derivan los dos juntos. Por eso el puerto del SoC ya no se llama
    `wdt_osc_tick` sino `osc_rc_tick`: un nombre que solo menciona a uno de sus dos
    usuarios es un nombre que miente.
    CON ESTE VECTOR, SOLO SPM_READY SE QUEDA SIN FUENTE, y ese es de la fase 4.
    EL BANCO DE EXTREMO A EXTREMO SE ESTABA LEYENDO A SI MISMO, y lo dijo la
    mutacion. hello.c grababa 0x5A en la EEPROM y lo leia de v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
2026-09-22 docs: los .md contra el estado medido, uno por uno
    Repaso de los quince documentos del repositorio contra lo que imprime `make`.
    Lo que salio:
    D15 ESTABA CITADA EN EL RTL Y NO EXISTIA EN NINGUN SITIO MAS. Un comentario de
    axioma_eeprom.v decia «es la deuda D15, declarada en el registro» y el registro
    no la tenia. Es EXACTAMENTE el fallo que documenta D13 -«lo peor de ella es
    donde estaba escrita: en un comentario del RTL y en ningun otro sitio»- y se
    repitio cuatro dias despues de escribirlo. Ya esta declarada: leer la EEPROM no
    para el nucleo cuatro ciclos, y eso rompe L3 en las instrucciones que siguen a
    un EERE. Se justifica por escrito: parar el nucleo no es cosa del periferico,
    hac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
2026-09-22 verif: una puerta para las deudas que cita el codigo
    D13 dejo escrita una leccion: lo peor de esa deuda no era la deuda, era DONDE
    ESTABA ESCRITA — en un comentario del RTL y en ningun otro sitio. CUATRO DIAS
    DESPUES, un comentario de axioma_eeprom.v decia «es la deuda D15, declarada en
    el registro» y el registro no la tenia. La leccion estaba escrita, en un
    documento del propio repositorio, y se repitio igual.
    Lo que no falla es lo que se comprueba. `make check-docs` busca ahora en el RTL
    y en los bancos cualquier comentario que cite una deuda y exige que exista su
    fila en docs/06-deuda-tecnica.md. Si falta, dice el fichero y la linea.
    SE BUSCA LA CITA Y NO EL NUMERO, y eso importa: `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
2026-09-23 adc: el disparo automatico, y un banco que mira los cables del SoC
    Cierra la deuda D14, la ultima de la fase 3. Lo que la tenia abierta era
    una dependencia y no una dificultad: dos de sus ocho fuentes no existian,
    porque el comparador analogico es de esta misma fase. Con el dentro, se
    cierra entera.
    Las ocho fuentes de la tabla 23-6 quedan cableadas en el SoC en una tabla
    donde el indice ES el valor de ADTS, de modo que una fuente mal cableada
    se ve leyendo una linea.
    Tres cosas que no son obvias:
    El disparo va por el FLANCO de la bandera, no por su nivel. Las banderas
    se quedan puestas, asi que con nivel una sola comparacion del Timer0
    encadenaria conversiones para siempre. Y hay un caso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
2026-09-23 clkctrl: el modulo del reloj, y la decision de cortar relojes de verdad
    El decimo y ultimo periferico de la fase 3, y el unico que no hace nada
    por si solo: lo que hace es decidir quien se mueve y cuando.
    CLKPR divide el reloj del sistema y PRR apaga perifericos uno a uno. Se
    podia hacer de tres formas y solo una es honesta, asi que la decision
    queda escrita en el ADR 0003.
    Guardar los bits y no hacer nada no valia. Un programa que baja a f/8
    para ahorrar corriente seguiria viendo la USART a la velocidad de antes:
    el baudio sale mal por un factor de ocho. No es incompatibilidad de
    detalle, es un dispositivo que no habla. Y habria sido la cuarta deuda de
    la forma "los bits se almacenan y se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
    [axioma_clkctrl.v, coverage.py, mutation.py, synth_check.py, tb_clkctrl.cpp]
2026-09-23 soc: el chip entero pasa a habilitacion de reloj
    Segundo paso del ADR 0003: reparte `ce_cpu` y `ce_io` por los diecinueve
    modulos y los cuarenta y un bloques secuenciales. Son dos y no uno porque
    la figura 9-1 los separa -`clk_CPU` para el nucleo, la memoria y el bus;
    `clk_I/O` para los perifericos-, y porque el sueño los necesita
    separados: en modo Idle el primero se para y el segundo sigue.
    La red que hace segura la conversion es que con CLKPS=0 la habilitacion
    vale 1 siempre, o sea que el chip queda BIT A BIT como estaba. El
    diferencial contra simavr da 20/20 programas y 97/97 mnemonicos sin tocar
    una linea, y cada banco de modulo sigue siendo el de antes.
    Y ESA MISMA RED ES UN AGUJERO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
2026-09-23 clkctrl: el sueño, y la fase 3 con sus diez perifericos
    Tercer paso del ADR 0003. `SLEEP` sale del secuenciador como un pulso
    igual que `WDR` y llega al control de reloj, que es quien decide. Sin
    `SE` es un NOP, que es lo que dice la hoja de datos y lo que hace
    posible el idioma de avr-libc: poner SE, dormir, y volver a quitarlo
    para que un SLEEP perdido en el codigo no pare el chip.
    `make sim-sleep` comprueba lo que SLEEP hace, que es dejar de hacer. Lo
    unico que se puede medir de eso es desde fuera y con el tiempo en la
    mano, y los cuatro casos estan elegidos para que entre los dos primeros
    y los dos ultimos quede demostrado que clk_CPU y clk_I/O son dos relojes
    y no uno:
    Idle mas des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
2026-09-23 gpio: PUD apaga los pull-up de los tres puertos
    Primera mitad del paso 4 del ADR 0003. `PUD` vive en `MCUCR`, que es un
    registro del control de reloj, y lo que apaga son los pull-up de los tres
    puertos de E/S.
    La hoja de datos lo pone POR ENCIMA de los dos registros del puerto -«the
    pull-ups in the I/O ports are disabled EVEN IF the DDxn and PORTxn
    registers are configured to enable the pull-ups»-, asi que en el RTL va
    con una `and` aparte y al final, no metido en la ecuacion. No es estilo:
    un RTL que lo tratara como una condicion mas pasaria una prueba escrita
    de cualquier otra forma, y lo que hay que comprobar es justamente que
    apaga CUANDO LOS OTROS DOS PIDEN LO CONTRARIO. El banco del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
2026-09-23 soc: PRR apaga los siete perifericos, y el ADC arranca de una escritura
    Segunda mitad del paso 4 del ADR 0003, y con ella el control de reloj
    queda entero.
    Con la habilitacion ya repartida, `PRR` es UNA `and` POR MODULO:
    `ce_io & ~prr[n]`. Eso es lo que el ADR argumentaba que saldria gratis, y
    sale. El bit 4 no existe -la tabla 10-2 tiene siete bits y el hueco esta
    en medio- y se declara sin usar a proposito, igual que OCF0B y OCF1A en
    la tabla del disparo del ADC.
    Un periferico apagado se queda CONGELADO en el estado que tenia y al
    encenderlo sigue donde estaba, que es literalmente lo que promete la hoja
    de datos para el Timer0: «operation will continue like before the
    shutdown». No hac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
2026-09-23 soc: el barrido semantico del mapa, bit a bit
    656 bits en 82 registros: 393 de almacenamiento, 134 con comportamiento
    propio y 129 reservados. NINGUNO SIN CLASIFICAR.
    `make sim-soc` comprueba el mapa de DIRECCIONES, y eso deja entera la
    pregunta que de verdad decide si un sketch funciona: dentro de un
    registro que si existe, que hace cada bit. Un registro puede estar en su
    direccion, leerse y escribirse, y tener un bit reservado que devuelve
    basura, o uno de solo lectura que se deja escribir, o una bandera de las
    que se limpian con un uno que se comporta como almacenamiento.
    El valor de este banco esta en DE DONDE SALE CADA MITAD. Que bits existen
    lo genera `tools/gen_regmap.py` preguntand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
2026-09-23 soc: que la base de tiempo no derive, medido en dos ventanas
    Una de las tres clausulas del criterio de aceptacion de la fase 3, y
    conviene decir que se demuestra: `micros()` es una funcion de una
    biblioteca y aqui no se compila ninguna.
    `micros()` y `millis()` se apoyan en UNA SOLA COSA del hardware: que el
    Timer0 desborde cada 256 cuentas y que ninguno de esos desbordamientos se
    pierda. Si se pierde uno, el reloj del programa se retrasa 1 024 us DE
    GOLPE Y NO SE RECUPERA NUNCA. No es un redondeo que se promedie: es un
    escalon permanente.
    Se mide con el chip incomodo -otra interrupcion compitiendo y secciones
    con las interrupciones apagadas, que es lo que hace cualquier biblioteca
    al tocar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
2026-09-23 soc: el barrido de direcciones I2C, con un esclavo de verdad
    La tercera clausula del criterio de aceptacion de la fase 3, y esta bien
    elegida porque es la prueba que mas cosas tiene que atravesar a la vez:
    el nucleo ejecutando un bucle con saltos condicionales y espera por
    bandera; el TWI generando START, direccion, ACK/NACK y STOP CIENTO
    VEINTISIETE VECES SEGUIDAS sin colgarse ni una; los codigos de estado
    de TWSR siendo los de la tabla porque EL PROGRAMA DECIDE CON ELLOS —si
    0x18 y 0x20 se confundieran, el barrido diria que hay un esclavo en
    cada direccion o en ninguna—; y los pines como colector abierto de
    verdad, con el esclavo contestando al tirar de la linea que el m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
2026-09-23 docs: la auditoria de cifras, contra lo medido
    Repaso de todo lo publicado contra la salida real de las herramientas,
    porque despues de la habilitacion de reloj, el control de reloj y el
    barrido semantico habia cifras congeladas en el momento en que se
    escribieron.
    LAS DEL FPGA SE VOLVIERON A MEDIR, no a estimar: `make bitstream-ulx3s`
    da hoy 300 KiB, 35,4 % de las LUT y 60,7 % de la BRAM de la ULX3S 25F, y
    `nextpnr` mide Fmax 18,25 MHz TRAS EL RUTADO -no la de despues del
    emplazamiento, que sale 14,37 y no es la buena-. El README decia 301 KiB,
    36,6 % y 18,88 MHz, que eran de antes de que entraran dos perifericos y
    la habilitacion de reloj de todo el chip.
    LAS DE AREA POR MODULO estaban e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
2026-09-23 build: `make check-all` funciona desde un clon limpio
    Verificar el estado publicado clonandolo y ejecutandolo encontro un fallo
    que ninguna puerta podia ver: `make check-all` fallaba LOS CUARENTA Y DOS
    OBJETIVOS a la vez con «No such file or directory».
    La regresion escribe el registro de cada objetivo en `build/` ANTES de
    que ninguno haya corrido, y en un arbol recien clonado ese directorio
    todavia no existe: lo crean los objetivos al compilar. En este arbol
    lleva meses ahi, asi que el fallo era invisible desde dentro. Y es el
    PRIMER comando que ejecuta quien acaba de clonar el repositorio.
    Arreglado con un `mkdir -p`, y vuelto a verificar desde el clon: 42/42 en
    verde. Queda escrito en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
    [gen_diagrams.py]
2026-09-23 spm: la Flash por paginas, y con ella el vector 25
    Cierra la deuda D2 y abre la fase 4. Lo que habia era la escritura de UNA
    PALABRA: SPM cogia R1:R0 y lo metia en la Flash en la direccion de Z.
    Funcionaba, estaba verificado, y no servia para nada, porque ningun
    gestor de arranque escribe palabras sueltas: la Flash no se puede
    escribir asi. Una celda solo sabe BAJAR bits; para subirlos hay que
    BORRAR, y el borrado es por PAGINAS.
    EL CAMBIO DE FONDO ES QUE EL NUCLEO YA NO ESCRIBE LA FLASH. `SPM` pasa de
    ser una escritura a ser una PETICION: el secuenciador saca un pulso con Z
    y R1:R0, y lo que ocurra lo decide SPMCSR. Quien escribe es
    rtl/periph/axioma_spm.v, que es quien sabe de paginas, de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
2026-09-23 docs: la fase 3 queda cerrada y la 4 en marcha
    Las tres clausulas del criterio de aceptacion de la fase 3 estan
    demostradas, con un comando cada una: 25 de 25 vectores (check-docs
    contra el cableado de irq_src), micros() sin deriva (sim-micros, dos
    ventanas con el mismo desvio) y el scanner I2C (sim-i2c, 127 direcciones
    con un esclavo real).
    La fase 4 arranca con el SPM por paginas ya hecho, que era su primera
    pieza y la que bloqueaba al resto: sin el no hay gestor de arranque.
    Quedan el gestor STK500v1, IVSEL -la deuda D16, que se desbloquea sola en
    cuanto haya seccion de arranque-, axioma.conf y el paquete del IDE.
2026-09-23 docs: repaso de todos los documentos contra el estado real
    Auditoria de los dieciseis .md del repositorio, cada afirmacion contra la
    salida de un comando. Lo que se corrige, por orden de gravedad:
    EL ARBOL DE 01-arquitectura.md SE QUEDABA EN LA EEPROM. Le faltaban
    axioma_clkctrl y axioma_spm, y debajo tenia una tabla de «lo que todavia
    no existe» que ya estaba vacia. Ese documento dice de si mismo que un
    arbol que enseña modulos inexistentes es la forma mas facil de creer que
    algo esta hecho; el fallo contrario -no enseñar lo que si existe- es el
    mismo error con el signo cambiado.
    LA FASE 3 SEGUIA ABIERTA EN CUATRO SITIOS. Sus tres clausulas estan
    demostradas desde que el SPM trajo el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
2026-09-25 docs: donde comprar la placa, con enlaces comprobados uno a uno
    La tabla de placas del README daba precios aproximados y ningun enlace.
    Ahora lleva las referencias exactas de catalogo y enlaces que se
    comprobaron el 24-sep-2026, y de paso salieron tres cosas que cambian la
    recomendacion.
    LA VARIANTE 25F NO SE VENDE COMO REFERENCIA SUELTA. Radiona la documenta,
    pero lo que los distribuidores tienen en catalogo es CS-ULX3S-01 (12F),
    -02 (45F) y -03 (85F). El proyecto esta medido en la 25F porque es lo que
    fija el Makefile, y en una 45F o una 85F entra con mas holgura: son
    placas identicas con la FPGA mas grande. Recomendar una referencia que no
    se puede meter en un carrito no sirve de nada.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
2026-09-25 fw: el gestor de arranque STK500v1, en 500 bytes
    La segunda pieza de la fase 4, y la que convierte esto en algo usable:
    con el gestor dentro, programar la FPGA es conectar el cable y pulsar
    Upload. Ocupa 500 de los 512 bytes de presupuesto y el Makefile falla si
    se pasa.
    NO TIENE CODIGO DE FLASH PROPIO, Y ESO ES LO IMPORTANTE. Para borrar y
    escribir paginas usa <avr/boot.h> de avr-libc SIN TOCAR NADA:
    boot_page_erase, boot_page_fill, boot_page_write y boot_spm_busy_wait.
    Esas macros son asm en linea que escriben SPMCSR y ejecutan SPM con su
    secuencia de cuatro ciclos, escritas para el ATmega328P de verdad. O sea
    que este programa ES en si mismo una prueba del RTL: si axioma_spm no
    implement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
2026-09-25 docs: 55 ejecuciones instrumentadas, no 54
    La cobertura suma una ejecucion mas desde que el banco del gestor de
    arranque entro en la fusion. El numero lo imprime `make coverage`; aqui
    estaba copiado a mano y se quedo corto en el mismo commit que lo movio.
2026-09-25 sw: la pieza de avrdude y la placa del IDE, con sus puertas
    Las dos piezas de integracion de la fase 4, cada una con una puerta que
    la comprueba de verdad.
    `sw/avrdude/axioma.conf` define la pieza `axioma328` heredando del m328p
    y cambiando SOLO LA FIRMA. Hereda a proposito: repetir los tamaños y los
    tiempos es garantizar que un dia se desincronicen, y ademas son los
    mismos, porque este chip ES un 328P por dentro.
    LO VALIDA EL PROPIO AVRDUDE, que es el oraculo que corresponde aqui, y
    con las dos mitades: que CON el fichero liste «axioma328 =
    AxiomaCore-328», y que SIN EL no lo reconozca. Sin la segunda mitad, la
    primera pasaria igual el dia que la pieza viniera de la configuracion del
    s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
2026-09-25 fw: NeoPixel, el nivel L3 medido con un cronometro
    El sketch que el criterio de la fase 4 nombra por su nombre, y el unico
    que no se puede aprobar a ojo: en una tira WS2812B EL BIT ES LA ANCHURA
    DEL PULSO. Un cero son 350 ns de alto y un uno 700, con 150 de margen. A
    12,5 MHz un ciclo son 80 nanosegundos, asi que todo se juega en cuatro
    instrucciones.
    Por eso es el que de verdad ejercita el nivel L3 del contrato de
    compatibilidad. Todo lo demas de este repositorio comprueba que las
    instrucciones HAGAN lo correcto; esto comprueba que DUREN lo que dice el
    manual. Un SBI que costara tres ciclos en vez de dos no rompería ningun
    otro banco, y en una tira se veria como colores equivocados.
    `mak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
    [coverage.py, neopixel.c, tb_soc_neopixel.cpp]
2026-09-25 fw: Servo y tone(), dos ondas que hace el hardware y mide el banco
    Segundo y tercer sketch de la suite de la Capa 5, en un solo programa
    porque los dos producen su onda CON EL HARDWARE y se dejan corriendo a la
    vez. Que convivan no es comodidad del banco: es lo que demuestra que dos
    temporizadores con prescaler distinto no se pisan.
    El servo usa el MODO 14 del Timer1 -PWM rapido con el tope en ICR1-, que
    es el que usa la biblioteca Servo de Arduino y el unico que ejercita ICR1
    como TOP, con su registro temporal de 16 bits de por medio. Un servo no
    lee un valor: lee CUANTO DURA EL PULSO, 1 ms a un lado y 2 al otro. Si la
    trama se acorta tiembla; si el pulso se pasa, fuerza contra el tope.
    M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
2026-09-25 docs: lo que falta de la fase 4, escrito para retomarlo sin releer
    Se deja el estado y el pendiente con el detalle suficiente para continuar
    sin reconstruir el contexto.
    LAS CUATRO PIEZAS DE SOFTWARE DE LA FASE ESTAN HECHAS: el SPM por
    paginas, el gestor de arranque, axioma.conf y boards.txt. De los diez
    sketches hay tres, y son los tres que no se pueden aprobar a ojo:
    NeoPixel, Servo y tone(), cronometrados en el pin.
    DE LOS SIETE QUE FALTAN, TRES YA ESTAN CUBIERTOS por `make sim-hello`
    -Blink, Serial y analogWrite-, que decodifica del pin el LED, el texto y
    los seis canales de PWM. Contarlos otra vez como sketches nuevos seria
    inflar la cuenta, asi que se dice cuales son y por que no cue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
2026-09-26 audit: una excepcion a lint que llevaba semanas apagando la red
    Auditoria de lo que NINGUNA puerta puede ver, porque las puertas
    comprueban el chip y nadie comprueba las puertas. Cinco hallazgos.
    EL QUE IMPORTA: en el SoC, la linea que declara que reconocimientos de
    interrupcion no van a ninguna parte listaba los vectores 6, 21 y 23
    -perro guardian, ADC y comparador- de cuando esos perifericos no
    existian. LOS TRES LLEVABAN SEMANAS CON SU `ack` CONECTADO.
    Declarar «sin usar» algo que si se usa no rompe nada... salvo que apaga
    el aviso de lint EL DIA QUE ALGUIEN LO DESCONECTE, que es justo para lo
    que sirve. Comprobado desconectando el del perro guardian a mano: antes
    pasaba limpio, ahora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
